vuhuyhop197/SCARA/README.md

# Classifying objects on conveyor by SCARA robot
Step_Control folder: source code Stm32F4 to control stepper motor.
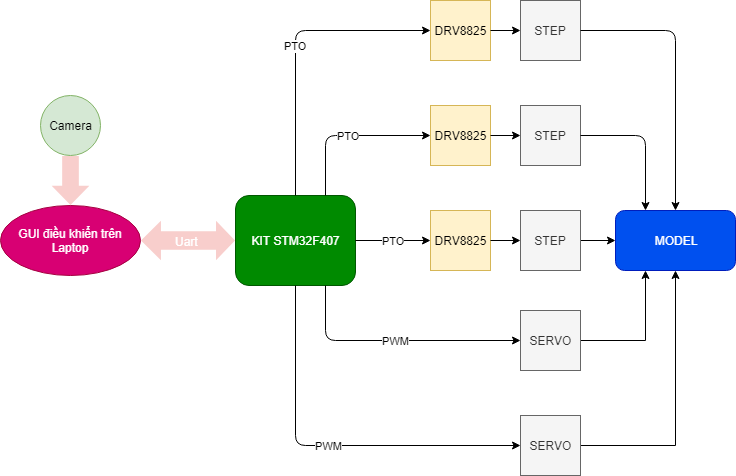
[picture p1: blockdiagram.png]
