vuhuyhop197/SCARA/Step_Control/MDK-ARM/LV_code_v2/LV_code_v2.htm

# Static Call Graph for image LV_code_v2\LV_code_v2.axf

#<CALLGRAPH># ARM Linker, 5060528: Last Updated: Sun Jun 02 16:51:38 2019

### Maximum Stack Usage = 240 bytes + Unknown(Cycles, Untraceable Function Pointers)

### Call chain for Maximum Stack Depth:

UART4_IRQHandler ⇒ HAL_UART_IRQHandler ⇒ UART_Receive_IT ⇒ HAL_UART_RxCpltCallback ⇒ Serial_RxCallback ⇒ Decode ⇒ DecodeParam ⇒ DecodeValue ⇒ ExecuteRequest ⇒ SetParamValue ⇒ Stepper_SetMinSPS ⇒ Stepper_SaveConfig ⇒ HAL_FLASH_Program ⇒ FLASH_WaitForLastOperation

### Mutually Recursive functions

- ADC_IRQHandler ⇒ ADC_IRQHandler
- BusFault_Handler ⇒ BusFault_Handler
- HardFault_Handler ⇒ HardFault_Handler
- MemManage_Handler ⇒ MemManage_Handler
- DecodeCmd ⇒ DecodeCmd
- UsageFault_Handler ⇒ UsageFault_Handler
- _Error_Handler ⇒ _Error_Handler

### Function Pointers

- ADC_IRQHandler from startup_stm32f407xx.o(.text) referenced from startup_stm32f407xx.o(RESET)
- BusFault_Handler from stm32f4xx_it.o(i.BusFault_Handler) referenced from startup_stm32f407xx.o(RESET)
- CAN1_RX0_IRQHandler from startup_stm32f407xx.o(.text) referenced from startup_stm32f407xx.o(RESET)
- CAN1_RX1_IRQHandler from startup_stm32f407xx.o(.text) referenced from startup_stm32f407xx.o(RESET)
- CAN1_SCE_IRQHandler from startup_stm32f407xx.o(.text) referenced from startup_stm32f407xx.o(RESET)
- CAN1_TX_IRQHandler from startup_stm32f407xx.o(.text) referenced from startup_stm32f407xx.o(RESET)
- CAN2_RX0_IRQHandler from startup_stm32f407xx.o(.text) referenced from startup_stm32f407xx.o(RESET)
- CAN2_RX1_IRQHandler from startup_stm32f407xx.o(.text) referenced from startup_stm32f407xx.o(RESET)
- CAN2_SCE_IRQHandler from startup_stm32f407xx.o(.text) referenced from startup_stm32f407xx.o(RESET)
- CAN2_TX_IRQHandler from startup_stm32f407xx.o(.text) referenced from startup_stm32f407xx.o(RESET)
- DCMI_IRQHandler from startup_stm32f407xx.o(.text) referenced from startup_stm32f407xx.o(RESET)
- DMA1_Stream0_IRQHandler from startup_stm32f407xx.o(.text) referenced from startup_stm32f407xx.o(RESET)
- DMA1_Stream1_IRQHandler from startup_stm32f407xx.o(.text) referenced from startup_stm32f407xx.o(RESET)
- DMA1_Stream2_IRQHandler from stm32f4xx_it.o(i.DMA1_Stream2_IRQHandler) referenced from startup_stm32f407xx.o(RESET)
- DMA1_Stream3_IRQHandler from startup_stm32f407xx.o(.text) referenced from startup_stm32f407xx.o(RESET)
- DMA1_Stream4_IRQHandler from stm32f4xx_it.o(i.DMA1_Stream4_IRQHandler) referenced from startup_stm32f407xx.o(RESET)
- DMA1_Stream5_IRQHandler from startup_stm32f407xx.o(.text) referenced from startup_stm32f407xx.o(RESET)
- DMA1_Stream6_IRQHandler from startup_stm32f407xx.o(.text) referenced from startup_stm32f407xx.o(RESET)
- DMA1_Stream7_IRQHandler from startup_stm32f407xx.o(.text) referenced from startup_stm32f407xx.o(RESET)
- DMA2_Stream0_IRQHandler from startup_stm32f407xx.o(.text) referenced from startup_stm32f407xx.o(RESET)
- DMA2_Stream1_IRQHandler from startup_stm32f407xx.o(.text) referenced from startup_stm32f407xx.o(RESET)
- DMA2_Stream2_IRQHandler from startup_stm32f407xx.o(.text) referenced from startup_stm32f407xx.o(RESET)
- DMA2_Stream3_IRQHandler from startup_stm32f407xx.o(.text) referenced from startup_stm32f407xx.o(RESET)
- DMA2_Stream4_IRQHandler from startup_stm32f407xx.o(.text) referenced from startup_stm32f407xx.o(RESET)
- DMA2_Stream5_IRQHandler from startup_stm32f407xx.o(.text) referenced from startup_stm32f407xx.o(RESET)
- DMA2_Stream6_IRQHandler from startup_stm32f407xx.o(.text) referenced from startup_stm32f407xx.o(RESET)
- DMA2_Stream7_IRQHandler from startup_stm32f407xx.o(.text) referenced from startup_stm32f407xx.o(RESET)
- DebugMon_Handler from stm32f4xx_it.o(i.DebugMon_Handler) referenced from startup_stm32f407xx.o(RESET)
- ETH_IRQHandler from startup_stm32f407xx.o(.text) referenced from startup_stm32f407xx.o(RESET)
- ETH_WKUP_IRQHandler from startup_stm32f407xx.o(.text) referenced from startup_stm32f407xx.o(RESET)
- EXTI0_IRQHandler from startup_stm32f407xx.o(.text) referenced from startup_stm32f407xx.o(RESET)
- EXTI15_10_IRQHandler from stm32f4xx_it.o(i.EXTI15_10_IRQHandler) referenced from startup_stm32f407xx.o(RESET)
- EXTI1_IRQHandler from startup_stm32f407xx.o(.text) referenced from startup_stm32f407xx.o(RESET)
- EXTI2_IRQHandler from startup_stm32f407xx.o(.text) referenced from startup_stm32f407xx.o(RESET)
- EXTI3_IRQHandler from startup_stm32f407xx.o(.text) referenced from startup_stm32f407xx.o(RESET)
- EXTI4_IRQHandler from startup_stm32f407xx.o(.text) referenced from startup_stm32f407xx.o(RESET)
- EXTI9_5_IRQHandler from startup_stm32f407xx.o(.text) referenced from startup_stm32f407xx.o(RESET)
- FLASH_IRQHandler from startup_stm32f407xx.o(.text) referenced from startup_stm32f407xx.o(RESET)
- FMC_IRQHandler from startup_stm32f407xx.o(.text) referenced from startup_stm32f407xx.o(RESET)
- FPU_IRQHandler from startup_stm32f407xx.o(.text) referenced from startup_stm32f407xx.o(RESET)
- HASH_RNG_IRQHandler from startup_stm32f407xx.o(.text) referenced from startup_stm32f407xx.o(RESET)
- HardFault_Handler from stm32f4xx_it.o(i.HardFault_Handler) referenced from startup_stm32f407xx.o(RESET)
- I2C1_ER_IRQHandler from startup_stm32f407xx.o(.text) referenced from startup_stm32f407xx.o(RESET)
- I2C1_EV_IRQHandler from startup_stm32f407xx.o(.text) referenced from startup_stm32f407xx.o(RESET)
- I2C2_ER_IRQHandler from startup_stm32f407xx.o(.text) referenced from startup_stm32f407xx.o(RESET)
- I2C2_EV_IRQHandler from startup_stm32f407xx.o(.text) referenced from startup_stm32f407xx.o(RESET)
- I2C3_ER_IRQHandler from startup_stm32f407xx.o(.text) referenced from startup_stm32f407xx.o(RESET)
- I2C3_EV_IRQHandler from startup_stm32f407xx.o(.text) referenced from startup_stm32f407xx.o(RESET)
- MemManage_Handler from stm32f4xx_it.o(i.MemManage_Handler) referenced from startup_stm32f407xx.o(RESET)
- NMI_Handler from stm32f4xx_it.o(i.NMI_Handler) referenced from startup_stm32f407xx.o(RESET)
- OTG_FS_IRQHandler from startup_stm32f407xx.o(.text) referenced from startup_stm32f407xx.o(RESET)
- OTG_FS_WKUP_IRQHandler from startup_stm32f407xx.o(.text) referenced from startup_stm32f407xx.o(RESET)
- OTG_HS_EP1_IN_IRQHandler from startup_stm32f407xx.o(.text) referenced from startup_stm32f407xx.o(RESET)
- OTG_HS_EP1_OUT_IRQHandler from startup_stm32f407xx.o(.text) referenced from startup_stm32f407xx.o(RESET)
- OTG_HS_IRQHandler from startup_stm32f407xx.o(.text) referenced from startup_stm32f407xx.o(RESET)
- OTG_HS_WKUP_IRQHandler from startup_stm32f407xx.o(.text) referenced from startup_stm32f407xx.o(RESET)
- PVD_IRQHandler from startup_stm32f407xx.o(.text) referenced from startup_stm32f407xx.o(RESET)
- PendSV_Handler from stm32f4xx_it.o(i.PendSV_Handler) referenced from startup_stm32f407xx.o(RESET)
- RCC_IRQHandler from startup_stm32f407xx.o(.text) referenced from startup_stm32f407xx.o(RESET)
- RTC_Alarm_IRQHandler from startup_stm32f407xx.o(.text) referenced from startup_stm32f407xx.o(RESET)
- RTC_WKUP_IRQHandler from startup_stm32f407xx.o(.text) referenced from startup_stm32f407xx.o(RESET)
- Reset_Handler from startup_stm32f407xx.o(.text) referenced from startup_stm32f407xx.o(RESET)
- SDIO_IRQHandler from startup_stm32f407xx.o(.text) referenced from startup_stm32f407xx.o(RESET)
- SPI1_IRQHandler from startup_stm32f407xx.o(.text) referenced from startup_stm32f407xx.o(RESET)
- SPI2_IRQHandler from startup_stm32f407xx.o(.text) referenced from startup_stm32f407xx.o(RESET)
- SPI3_IRQHandler from startup_stm32f407xx.o(.text) referenced from startup_stm32f407xx.o(RESET)
- SVC_Handler from stm32f4xx_it.o(i.SVC_Handler) referenced from startup_stm32f407xx.o(RESET)
- SysTick_Handler from stm32f4xx_it.o(i.SysTick_Handler) referenced from startup_stm32f407xx.o(RESET)
- SystemInit from system_stm32f4xx_1.o(i.SystemInit) referenced from startup_stm32f407xx.o(.text)
- TAMP_STAMP_IRQHandler from startup_stm32f407xx.o(.text) referenced from startup_stm32f407xx.o(RESET)
- TIM1_BRK_TIM9_IRQHandler from startup_stm32f407xx.o(.text) referenced from startup_stm32f407xx.o(RESET)
- TIM1_CC_IRQHandler from startup_stm32f407xx.o(.text) referenced from startup_stm32f407xx.o(RESET)
- TIM1_TRG_COM_TIM11_IRQHandler from startup_stm32f407xx.o(.text) referenced from startup_stm32f407xx.o(RESET)
- TIM1_UP_TIM10_IRQHandler from startup_stm32f407xx.o(.text) referenced from startup_stm32f407xx.o(RESET)
- TIM2_IRQHandler from startup_stm32f407xx.o(.text) referenced from startup_stm32f407xx.o(RESET)
- TIM3_IRQHandler from stm32f4xx_it.o(i.TIM3_IRQHandler) referenced from startup_stm32f407xx.o(RESET)
- TIM4_IRQHandler from stm32f4xx_it.o(i.TIM4_IRQHandler) referenced from startup_stm32f407xx.o(RESET)
- TIM5_IRQHandler from stm32f4xx_it.o(i.TIM5_IRQHandler) referenced from startup_stm32f407xx.o(RESET)
- TIM6_DAC_IRQHandler from startup_stm32f407xx.o(.text) referenced from startup_stm32f407xx.o(RESET)
- TIM7_IRQHandler from startup_stm32f407xx.o(.text) referenced from startup_stm32f407xx.o(RESET)
- TIM8_BRK_TIM12_IRQHandler from startup_stm32f407xx.o(.text) referenced from startup_stm32f407xx.o(RESET)
- TIM8_CC_IRQHandler from startup_stm32f407xx.o(.text) referenced from startup_stm32f407xx.o(RESET)
- TIM8_TRG_COM_TIM14_IRQHandler from stm32f4xx_it.o(i.TIM8_TRG_COM_TIM14_IRQHandler) referenced from startup_stm32f407xx.o(RESET)
- TIM8_UP_TIM13_IRQHandler from startup_stm32f407xx.o(.text) referenced from startup_stm32f407xx.o(RESET)
- UART4_IRQHandler from stm32f4xx_it.o(i.UART4_IRQHandler) referenced from startup_stm32f407xx.o(RESET)
- UART5_IRQHandler from startup_stm32f407xx.o(.text) referenced from startup_stm32f407xx.o(RESET)
- UART_DMAAbortOnError from stm32f4xx_hal_uart.o(i.UART_DMAAbortOnError) referenced from stm32f4xx_hal_uart.o(i.HAL_UART_IRQHandler)
- UART_DMAError from stm32f4xx_hal_uart.o(i.UART_DMAError) referenced from stm32f4xx_hal_uart.o(i.HAL_UART_Receive_DMA)
- UART_DMAError from stm32f4xx_hal_uart.o(i.UART_DMAError) referenced from stm32f4xx_hal_uart.o(i.HAL_UART_Transmit_DMA)
- UART_DMAReceiveCplt from stm32f4xx_hal_uart.o(i.UART_DMAReceiveCplt) referenced from stm32f4xx_hal_uart.o(i.HAL_UART_Receive_DMA)
- UART_DMARxHalfCplt from stm32f4xx_hal_uart.o(i.UART_DMARxHalfCplt) referenced from stm32f4xx_hal_uart.o(i.HAL_UART_Receive_DMA)
- UART_DMATransmitCplt from stm32f4xx_hal_uart.o(i.UART_DMATransmitCplt) referenced from stm32f4xx_hal_uart.o(i.HAL_UART_Transmit_DMA)
- UART_DMATxHalfCplt from stm32f4xx_hal_uart.o(i.UART_DMATxHalfCplt) referenced from stm32f4xx_hal_uart.o(i.HAL_UART_Transmit_DMA)
- USART1_IRQHandler from startup_stm32f407xx.o(.text) referenced from startup_stm32f407xx.o(RESET)
- USART2_IRQHandler from startup_stm32f407xx.o(.text) referenced from startup_stm32f407xx.o(RESET)
- USART3_IRQHandler from startup_stm32f407xx.o(.text) referenced from startup_stm32f407xx.o(RESET)
- USART6_IRQHandler from startup_stm32f407xx.o(.text) referenced from startup_stm32f407xx.o(RESET)
- UsageFault_Handler from stm32f4xx_it.o(i.UsageFault_Handler) referenced from startup_stm32f407xx.o(RESET)
- WWDG_IRQHandler from startup_stm32f407xx.o(.text) referenced from startup_stm32f407xx.o(RESET)
- __main from entry.o(.ARM.Collect$$$$00000000) referenced from startup_stm32f407xx.o(.text)
- fputc from serial.o(i.fputc) referenced from printf5.o(i.__0printf$5)
- main from main.o(i.main) referenced from entry9a.o(.ARM.Collect$$$$0000000B)

### Global Symbols

__main (Thumb, 0 bytes, Stack size unknown bytes, entry.o(.ARM.Collect$$$$00000000))
[Address Reference Count : 1]

- startup_stm32f407xx.o(.text)

_main_stk (Thumb, 0 bytes, Stack size unknown bytes, entry2.o(.ARM.Collect$$$$00000001))

_main_scatterload (Thumb, 0 bytes, Stack size unknown bytes, entry5.o(.ARM.Collect$$$$00000004))

[Calls]

- >> __scatterload

__main_after_scatterload (Thumb, 0 bytes, Stack size unknown bytes, entry5.o(.ARM.Collect$$$$00000004))

[Called By]

- >> __scatterload

_main_clock (Thumb, 0 bytes, Stack size unknown bytes, entry7b.o(.ARM.Collect$$$$00000008))

_main_cpp_init (Thumb, 0 bytes, Stack size unknown bytes, entry8b.o(.ARM.Collect$$$$0000000A))

_main_init (Thumb, 0 bytes, Stack size unknown bytes, entry9a.o(.ARM.Collect$$$$0000000B))

__rt_final_cpp (Thumb, 0 bytes, Stack size unknown bytes, entry10a.o(.ARM.Collect$$$$0000000D))

__rt_final_exit (Thumb, 0 bytes, Stack size unknown bytes, entry11a.o(.ARM.Collect$$$$0000000F))

Reset_Handler (Thumb, 8 bytes, Stack size 0 bytes, startup_stm32f407xx.o(.text))
[Address Reference Count : 1]

- startup_stm32f407xx.o(RESET)

ADC_IRQHandler (Thumb, 0 bytes, Stack size 0 bytes, startup_stm32f407xx.o(.text))

[Calls]

- >> ADC_IRQHandler

[Called By]

- >> ADC_IRQHandler

[Address Reference Count : 1]

- startup_stm32f407xx.o(RESET)

CAN1_RX0_IRQHandler (Thumb, 0 bytes, Stack size 0 bytes, startup_stm32f407xx.o(.text))
[Address Reference Count : 1]

- startup_stm32f407xx.o(RESET)

CAN1_RX1_IRQHandler (Thumb, 0 bytes, Stack size 0 bytes, startup_stm32f407xx.o(.text))
[Address Reference Count : 1]

- startup_stm32f407xx.o(RESET)

CAN1_SCE_IRQHandler (Thumb, 0 bytes, Stack size 0 bytes, startup_stm32f407xx.o(.text))
[Address Reference Count : 1]

- startup_stm32f407xx.o(RESET)

CAN1_TX_IRQHandler (Thumb, 0 bytes, Stack size 0 bytes, startup_stm32f407xx.o(.text))
[Address Reference Count : 1]

- startup_stm32f407xx.o(RESET)

CAN2_RX0_IRQHandler (Thumb, 0 bytes, Stack size 0 bytes, startup_stm32f407xx.o(.text))
[Address Reference Count : 1]

- startup_stm32f407xx.o(RESET)

CAN2_RX1_IRQHandler (Thumb, 0 bytes, Stack size 0 bytes, startup_stm32f407xx.o(.text))
[Address Reference Count : 1]

- startup_stm32f407xx.o(RESET)

CAN2_SCE_IRQHandler (Thumb, 0 bytes, Stack size 0 bytes, startup_stm32f407xx.o(.text))
[Address Reference Count : 1]

- startup_stm32f407xx.o(RESET)

CAN2_TX_IRQHandler (Thumb, 0 bytes, Stack size 0 bytes, startup_stm32f407xx.o(.text))
[Address Reference Count : 1]

- startup_stm32f407xx.o(RESET)

DCMI_IRQHandler (Thumb, 0 bytes, Stack size 0 bytes, startup_stm32f407xx.o(.text))
[Address Reference Count : 1]

- startup_stm32f407xx.o(RESET)

DMA1_Stream0_IRQHandler (Thumb, 0 bytes, Stack size 0 bytes, startup_stm32f407xx.o(.text))
[Address Reference Count : 1]

- startup_stm32f407xx.o(RESET)

DMA1_Stream1_IRQHandler (Thumb, 0 bytes, Stack size 0 bytes, startup_stm32f407xx.o(.text))
[Address Reference Count : 1]

- startup_stm32f407xx.o(RESET)

DMA1_Stream3_IRQHandler (Thumb, 0 bytes, Stack size 0 bytes, startup_stm32f407xx.o(.text))
[Address Reference Count : 1]

- startup_stm32f407xx.o(RESET)

DMA1_Stream5_IRQHandler (Thumb, 0 bytes, Stack size 0 bytes, startup_stm32f407xx.o(.text))
[Address Reference Count : 1]

- startup_stm32f407xx.o(RESET)

DMA1_Stream6_IRQHandler (Thumb, 0 bytes, Stack size 0 bytes, startup_stm32f407xx.o(.text))
[Address Reference Count : 1]

- startup_stm32f407xx.o(RESET)

DMA1_Stream7_IRQHandler (Thumb, 0 bytes, Stack size 0 bytes, startup_stm32f407xx.o(.text))
[Address Reference Count : 1]

- startup_stm32f407xx.o(RESET)

DMA2_Stream0_IRQHandler (Thumb, 0 bytes, Stack size 0 bytes, startup_stm32f407xx.o(.text))
[Address Reference Count : 1]

- startup_stm32f407xx.o(RESET)

DMA2_Stream1_IRQHandler (Thumb, 0 bytes, Stack size 0 bytes, startup_stm32f407xx.o(.text))
[Address Reference Count : 1]

- startup_stm32f407xx.o(RESET)

DMA2_Stream2_IRQHandler (Thumb, 0 bytes, Stack size 0 bytes, startup_stm32f407xx.o(.text))
[Address Reference Count : 1]

- startup_stm32f407xx.o(RESET)

DMA2_Stream3_IRQHandler (Thumb, 0 bytes, Stack size 0 bytes, startup_stm32f407xx.o(.text))
[Address Reference Count : 1]

- startup_stm32f407xx.o(RESET)

DMA2_Stream4_IRQHandler (Thumb, 0 bytes, Stack size 0 bytes, startup_stm32f407xx.o(.text))
[Address Reference Count : 1]

- startup_stm32f407xx.o(RESET)

DMA2_Stream5_IRQHandler (Thumb, 0 bytes, Stack size 0 bytes, startup_stm32f407xx.o(.text))
[Address Reference Count : 1]

- startup_stm32f407xx.o(RESET)

DMA2_Stream6_IRQHandler (Thumb, 0 bytes, Stack size 0 bytes, startup_stm32f407xx.o(.text))
[Address Reference Count : 1]

- startup_stm32f407xx.o(RESET)

DMA2_Stream7_IRQHandler (Thumb, 0 bytes, Stack size 0 bytes, startup_stm32f407xx.o(.text))
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

- startup_stm32f407xx.o(RESET)

SDIO_IRQHandler (Thumb, 0 bytes, Stack size 0 bytes, startup_stm32f407xx.o(.text))
[Address Reference Count : 1]

- startup_stm32f407xx.o(RESET)

SPI1_IRQHandler (Thumb, 0 bytes, Stack size 0 bytes, startup_stm32f407xx.o(.text))
[Address Reference Count : 1]

- startup_stm32f407xx.o(RESET)

SPI2_IRQHandler (Thumb, 0 bytes, Stack size 0 bytes, startup_stm32f407xx.o(.text))
[Address Reference Count : 1]

- startup_stm32f407xx.o(RESET)

SPI3_IRQHandler (Thumb, 0 bytes, Stack size 0 bytes, startup_stm32f407xx.o(.text))
[Address Reference Count : 1]

- startup_stm32f407xx.o(RESET)

TAMP_STAMP_IRQHandler (Thumb, 0 bytes, Stack size 0 bytes, startup_stm32f407xx.o(.text))
[Address Reference Count : 1]

- startup_stm32f407xx.o(RESET)

TIM1_BRK_TIM9_IRQHandler (Thumb, 0 bytes, Stack size 0 bytes, startup_stm32f407xx.o(.text))
[Address Reference Count : 1]

- startup_stm32f407xx.o(RESET)

TIM1_CC_IRQHandler (Thumb, 0 bytes, Stack size 0 bytes, startup_stm32f407xx.o(.text))
[Address Reference Count : 1]

- startup_stm32f407xx.o(RESET)

TIM1_TRG_COM_TIM11_IRQHandler (Thumb, 0 bytes, Stack size 0 bytes, startup_stm32f407xx.o(.text))
[Address Reference Count : 1]

- startup_stm32f407xx.o(RESET)

TIM1_UP_TIM10_IRQHandler (Thumb, 0 bytes, Stack size 0 bytes, startup_stm32f407xx.o(.text))
[Address Reference Count : 1]

- startup_stm32f407xx.o(RESET)

TIM2_IRQHandler (Thumb, 0 bytes, Stack size 0 bytes, startup_stm32f407xx.o(.text))
[Address Reference Count : 1]

- startup_stm32f407xx.o(RESET)

TIM6_DAC_IRQHandler (Thumb, 0 bytes, Stack size 0 bytes, startup_stm32f407xx.o(.text))
[Address Reference Count : 1]

- startup_stm32f407xx.o(RESET)

TIM7_IRQHandler (Thumb, 0 bytes, Stack size 0 bytes, startup_stm32f407xx.o(.text))
[Address Reference Count : 1]

- startup_stm32f407xx.o(RESET)

TIM8_BRK_TIM12_IRQHandler (Thumb, 0 bytes, Stack size 0 bytes, startup_stm32f407xx.o(.text))
[Address Reference Count : 1]

- startup_stm32f407xx.o(RESET)

TIM8_CC_IRQHandler (Thumb, 0 bytes, Stack size 0 bytes, startup_stm32f407xx.o(.text))
[Address Reference Count : 1]

- startup_stm32f407xx.o(RESET)

TIM8_UP_TIM13_IRQHandler (Thumb, 0 bytes, Stack size 0 bytes, startup_stm32f407xx.o(.text))
[Address Reference Count : 1]

- startup_stm32f407xx.o(RESET)

UART5_IRQHandler (Thumb, 0 bytes, Stack size 0 bytes, startup_stm32f407xx.o(.text))
[Address Reference Count : 1]

- startup_stm32f407xx.o(RESET)

USART1_IRQHandler (Thumb, 0 bytes, Stack size 0 bytes, startup_stm32f407xx.o(.text))
[Address Reference Count : 1]

- startup_stm32f407xx.o(RESET)

USART2_IRQHandler (Thumb, 0 bytes, Stack size 0 bytes, startup_stm32f407xx.o(.text))
[Address Reference Count : 1]

- startup_stm32f407xx.o(RESET)

USART3_IRQHandler (Thumb, 0 bytes, Stack size 0 bytes, startup_stm32f407xx.o(.text))
[Address Reference Count : 1]

- startup_stm32f407xx.o(RESET)

USART6_IRQHandler (Thumb, 0 bytes, Stack size 0 bytes, startup_stm32f407xx.o(.text))
[Address Reference Count : 1]

- startup_stm32f407xx.o(RESET)

WWDG_IRQHandler (Thumb, 0 bytes, Stack size 0 bytes, startup_stm32f407xx.o(.text))
[Address Reference Count : 1]

- startup_stm32f407xx.o(RESET)

__aeabi_uldivmod (Thumb, 98 bytes, Stack size 40 bytes, uldiv.o(.text))

[Stack]

- Max Depth = 40
- Call Chain = __aeabi_uldivmod

[Calls]

- >> __aeabi_llsr
- >> __aeabi_llsl

[Called By]

- >> HAL_RCC_GetSysClockFreq
- >> _printf_core

__aeabi_memcpy (Thumb, 36 bytes, Stack size 0 bytes, memcpya.o(.text), UNUSED)

__aeabi_memcpy4 (Thumb, 0 bytes, Stack size 0 bytes, memcpya.o(.text))

[Called By]

- >> main

__aeabi_memcpy8 (Thumb, 0 bytes, Stack size 0 bytes, memcpya.o(.text), UNUSED)

strlen (Thumb, 14 bytes, Stack size 0 bytes, strlen.o(.text))

[Called By]

- >> DecodeParam
- >> DecodeCmd
- >> HAL_UART_TxCpltCallback

__aeabi_l2f (Thumb, 44 bytes, Stack size 16 bytes, ffltl.o(.text))

[Stack]

- Max Depth = 20
- Call Chain = __aeabi_l2f ⇒ _float_epilogue

[Calls]

- >> _float_epilogue

[Called By]

- >> ExecuteRequest
- >> ExecuteController

__aeabi_llsl (Thumb, 30 bytes, Stack size 0 bytes, llshl.o(.text))

[Called By]

- >> __aeabi_uldivmod

_ll_shift_l (Thumb, 0 bytes, Stack size 0 bytes, llshl.o(.text), UNUSED)

__aeabi_llsr (Thumb, 32 bytes, Stack size 0 bytes, llushr.o(.text))

[Called By]

- >> __aeabi_uldivmod

_ll_ushift_r (Thumb, 0 bytes, Stack size 0 bytes, llushr.o(.text), UNUSED)

__I$use$fp (Thumb, 0 bytes, Stack size 0 bytes, iusefp.o(.text), UNUSED)

_float_round (Thumb, 18 bytes, Stack size 0 bytes, fepilogue.o(.text), UNUSED)

_float_epilogue (Thumb, 92 bytes, Stack size 4 bytes, fepilogue.o(.text))

[Stack]

- Max Depth = 4
- Call Chain = _float_epilogue

[Called By]

- >> __aeabi_l2f

__scatterload (Thumb, 28 bytes, Stack size 0 bytes, init.o(.text))

[Calls]

- >> __main_after_scatterload

[Called By]

- >> _main_scatterload

__scatterload_rt2 (Thumb, 0 bytes, Stack size 0 bytes, init.o(.text), UNUSED)

BusFault_Handler (Thumb, 2 bytes, Stack size 0 bytes, stm32f4xx_it.o(i.BusFault_Handler))

[Calls]

- >> BusFault_Handler

[Called By]

- >> BusFault_Handler

[Address Reference Count : 1]

- startup_stm32f407xx.o(RESET)

Calib_Home (Thumb, 140 bytes, Stack size 8 bytes, main.o(i.Calib_Home))

[Stack]

- Max Depth = 16
- Call Chain = Calib_Home ⇒ Stepper_SetTargetPosition

[Calls]

- >> HAL_GPIO_WritePin
- >> Stepper_SetTargetPosition
- >> Stepper_SetCurrentPosition
- >> Stepper_GetStatus
- >> Stepper_GetCurrentPosition

[Called By]

- >> main

CleanupDecoder (Thumb, 26 bytes, Stack size 0 bytes, steppercommands.o(i.CleanupDecoder))

[Called By]

- >> DecodeValue
- >> DecodeStepper

DMA1_Stream2_IRQHandler (Thumb, 6 bytes, Stack size 0 bytes, stm32f4xx_it.o(i.DMA1_Stream2_IRQHandler))

[Stack]

- Max Depth = 32
- Call Chain = DMA1_Stream2_IRQHandler ⇒ HAL_DMA_IRQHandler

[Calls]

- >> HAL_DMA_IRQHandler

[Address Reference Count : 1]

- startup_stm32f407xx.o(RESET)

DMA1_Stream4_IRQHandler (Thumb, 6 bytes, Stack size 0 bytes, stm32f4xx_it.o(i.DMA1_Stream4_IRQHandler))

[Stack]

- Max Depth = 32
- Call Chain = DMA1_Stream4_IRQHandler ⇒ HAL_DMA_IRQHandler

[Calls]

- >> HAL_DMA_IRQHandler

[Address Reference Count : 1]

- startup_stm32f407xx.o(RESET)

DebugMon_Handler (Thumb, 2 bytes, Stack size 0 bytes, stm32f4xx_it.o(i.DebugMon_Handler))
[Address Reference Count : 1]

- startup_stm32f407xx.o(RESET)

Decode (Thumb, 48 bytes, Stack size 0 bytes, steppercommands.o(i.Decode))

[Stack]

- Max Depth = 200
- Call Chain = Decode ⇒ DecodeParam ⇒ DecodeValue ⇒ ExecuteRequest ⇒ SetParamValue ⇒ Stepper_SetMinSPS ⇒ Stepper_SaveConfig ⇒ HAL_FLASH_Program ⇒ FLASH_WaitForLastOperation

[Calls]

- >> DecodeValue
- >> DecodeStepper
- >> DecodeParam
- >> DecodeCmd

[Called By]

- >> Serial_RxCallback

DecodeCmd (Thumb, 180 bytes, Stack size 40 bytes, steppercommands.o(i.DecodeCmd))

[Stack]

- Max Depth = 40 + In Cycle
- Call Chain = DecodeCmd ⇒ DecodeCmd (Cycle)

[Calls]

- >> DecodeCmd
- >> strlen

[Called By]

- >> DecodeValue
- >> DecodeStepper
- >> DecodeCmd
- >> Decode

DecodeParam (Thumb, 210 bytes, Stack size 40 bytes, steppercommands.o(i.DecodeParam))

[Stack]

- Max Depth = 200
- Call Chain = DecodeParam ⇒ DecodeValue ⇒ ExecuteRequest ⇒ SetParamValue ⇒ Stepper_SetMinSPS ⇒ Stepper_SaveConfig ⇒ HAL_FLASH_Program ⇒ FLASH_WaitForLastOperation

[Calls]

- >> DecodeValue
- >> strlen

[Called By]

- >> Decode

DecodeStepper (Thumb, 48 bytes, Stack size 8 bytes, steppercommands.o(i.DecodeStepper))

[Stack]

- Max Depth = 144
- Call Chain = DecodeStepper ⇒ ExecuteRequest ⇒ SetParamValue ⇒ Stepper_SetMinSPS ⇒ Stepper_SaveConfig ⇒ HAL_FLASH_Program ⇒ FLASH_WaitForLastOperation

[Calls]

- >> ExecuteRequest
- >> DecodeCmd
- >> CleanupDecoder
- >> Stepper_GetStatus

[Called By]

- >> Decode

DecodeValue (Thumb, 170 bytes, Stack size 24 bytes, steppercommands.o(i.DecodeValue))

[Stack]

- Max Depth = 160
- Call Chain = DecodeValue ⇒ ExecuteRequest ⇒ SetParamValue ⇒ Stepper_SetMinSPS ⇒ Stepper_SaveConfig ⇒ HAL_FLASH_Program ⇒ FLASH_WaitForLastOperation

[Calls]

- >> ExecuteRequest
- >> DecodeCmd
- >> CleanupDecoder

[Called By]

- >> DecodeParam
- >> Decode

DecrementSPS (Thumb, 22 bytes, Stack size 0 bytes, steppercontroller.o(i.DecrementSPS))

[Stack]

- Max Depth = 8
- Call Chain = DecrementSPS ⇒ SetStepTimerByCurrentSPS

[Calls]

- >> SetStepTimerByCurrentSPS

[Called By]

- >> ExecuteController

EXTI15_10_IRQHandler (Thumb, 22 bytes, Stack size 8 bytes, stm32f4xx_it.o(i.EXTI15_10_IRQHandler))

[Stack]

- Max Depth = 32
- Call Chain = EXTI15_10_IRQHandler ⇒ HAL_GPIO_EXTI_IRQHandler ⇒ HAL_GPIO_EXTI_Callback

[Calls]

- >> HAL_GPIO_EXTI_IRQHandler

[Address Reference Count : 1]

- startup_stm32f407xx.o(RESET)

ExecuteController (Thumb, 316 bytes, Stack size 24 bytes, steppercontroller.o(i.ExecuteController))

[Stack]

- Max Depth = 44
- Call Chain = ExecuteController ⇒ __aeabi_l2f ⇒ _float_epilogue

[Calls]

- >> HAL_TIM_PWM_Start
- >> __aeabi_l2f
- >> IncrementSPS
- >> GetStepsToTarget
- >> DecrementSPS

[Called By]

- >> Stepper_ExecuteAllControllers

ExecuteRequest (Thumb, 588 bytes, Stack size 32 bytes, steppercommands.o(i.ExecuteRequest))

[Stack]

- Max Depth = 136
- Call Chain = ExecuteRequest ⇒ SetParamValue ⇒ Stepper_SetMinSPS ⇒ Stepper_SaveConfig ⇒ HAL_FLASH_Program ⇒ FLASH_WaitForLastOperation

[Calls]

- >> Set_Orient
- >> Set_Home
- >> Grap_object
- >> SetParamValue
- >> PrintStepperStatusStr
- >> GetParamValue
- >> __aeabi_l2f
- >> Stepper_SetMinSPS
- >> Stepper_SetMaxSPS
- >> Stepper_SetCurrentPosition
- >> Stepper_SaveConfig
- >> Stepper_InitDefaultState
- >> Stepper_GetStatus
- >> __2printf

[Called By]

- >> main
- >> DecodeValue
- >> DecodeStepper

FLASH_Erase_Sector (Thumb, 76 bytes, Stack size 0 bytes, stm32f4xx_hal_flash_ex.o(i.FLASH_Erase_Sector))

[Called By]

- >> Stepper_SaveConfig

FLASH_WaitForLastOperation (Thumb, 76 bytes, Stack size 16 bytes, stm32f4xx_hal_flash.o(i.FLASH_WaitForLastOperation))

[Stack]

- Max Depth = 16
- Call Chain = FLASH_WaitForLastOperation

[Calls]

- >> FLASH_SetErrorCode
- >> HAL_GetTick

[Called By]

- >> HAL_FLASH_Program

GetParamValue (Thumb, 54 bytes, Stack size 0 bytes, steppercommands.o(i.GetParamValue))

[Stack]

- Max Depth = 4
- Call Chain = GetParamValue ⇒ Stepper_GetTargetPosition

[Calls]

- >> Stepper_GetTargetPosition
- >> Stepper_GetStatus
- >> Stepper_GetMinSPS
- >> Stepper_GetMaxSPS
- >> Stepper_GetCurrentSPS
- >> Stepper_GetCurrentPosition
- >> Stepper_GetAccSPS
- >> Stepper_GetAccPrescaler

[Called By]

- >> ExecuteRequest

GetState (Thumb, 40 bytes, Stack size 0 bytes, steppercontroller.o(i.GetState))

[Called By]

- >> Stepper_SetupPeripherals
- >> Stepper_SetTargetPosition
- >> Stepper_SetMinSPS
- >> Stepper_SetMaxSPS
- >> Stepper_SetCurrentPosition
- >> Stepper_SetAccSPS
- >> Stepper_SetAccPrescaler
- >> Stepper_PulseTimerUpdate
- >> Stepper_InitDefaultState
- >> Stepper_GetTargetPosition
- >> Stepper_GetStatus
- >> Stepper_GetMinSPS
- >> Stepper_GetMaxSPS
- >> Stepper_GetCurrentSPS
- >> Stepper_GetCurrentPosition
- >> Stepper_GetAccSPS
- >> Stepper_GetAccPrescaler

GetStepDirectionUnit (Thumb, 18 bytes, Stack size 0 bytes, steppercontroller.o(i.GetStepDirectionUnit))

[Called By]

- >> Stepper_PulseTimerUpdate
- >> GetStepsToTarget

GetStepsToTarget (Thumb, 40 bytes, Stack size 12 bytes, steppercontroller.o(i.GetStepsToTarget))

[Stack]

- Max Depth = 12
- Call Chain = GetStepsToTarget

[Calls]

- >> GetStepDirectionUnit

[Called By]

- >> Stepper_PulseTimerUpdate
- >> ExecuteController

Grap_object (Thumb, 44 bytes, Stack size 8 bytes, main.o(i.Grap_object))

[Stack]

- Max Depth = 24
- Call Chain = Grap_object ⇒ HAL_TIM_PWM_Start ⇒ TIM_CCxChannelCmd

[Calls]

- >> HAL_TIM_PWM_Start

[Called By]

- >> ExecuteRequest

HAL_DMA_Abort_IT (Thumb, 36 bytes, Stack size 0 bytes, stm32f4xx_hal_dma.o(i.HAL_DMA_Abort_IT))

[Called By]

- >> HAL_UART_IRQHandler

HAL_DMA_IRQHandler (Thumb, 460 bytes, Stack size 32 bytes, stm32f4xx_hal_dma.o(i.HAL_DMA_IRQHandler))

[Stack]

- Max Depth = 32
- Call Chain = HAL_DMA_IRQHandler

[Called By]

- >> DMA1_Stream4_IRQHandler
- >> DMA1_Stream2_IRQHandler

HAL_DMA_Init (Thumb, 208 bytes, Stack size 24 bytes, stm32f4xx_hal_dma.o(i.HAL_DMA_Init))

[Stack]

- Max Depth = 32
- Call Chain = HAL_DMA_Init ⇒ DMA_CheckFifoParam

[Calls]

- >> DMA_CheckFifoParam
- >> DMA_CalcBaseAndBitshift
- >> HAL_GetTick

[Called By]

- >> HAL_UART_MspInit

HAL_DMA_Start_IT (Thumb, 120 bytes, Stack size 24 bytes, stm32f4xx_hal_dma.o(i.HAL_DMA_Start_IT))

[Stack]

- Max Depth = 36
- Call Chain = HAL_DMA_Start_IT ⇒ DMA_SetConfig

[Calls]

- >> DMA_SetConfig

[Called By]

- >> HAL_UART_Transmit_DMA
- >> HAL_UART_Receive_DMA

HAL_Delay (Thumb, 32 bytes, Stack size 16 bytes, stm32f4xx_hal.o(i.HAL_Delay))

[Stack]

- Max Depth = 16
- Call Chain = HAL_Delay

[Calls]

- >> HAL_GetTick

[Called By]

- >> main

HAL_FLASH_Lock (Thumb, 14 bytes, Stack size 0 bytes, stm32f4xx_hal_flash.o(i.HAL_FLASH_Lock))

[Called By]

- >> Stepper_SaveConfig

HAL_FLASH_Program (Thumb, 116 bytes, Stack size 32 bytes, stm32f4xx_hal_flash.o(i.HAL_FLASH_Program))

[Stack]

- Max Depth = 48
- Call Chain = HAL_FLASH_Program ⇒ FLASH_WaitForLastOperation

[Calls]

- >> FLASH_WaitForLastOperation
- >> FLASH_Program_Word
- >> FLASH_Program_HalfWord
- >> FLASH_Program_DoubleWord
- >> FLASH_Program_Byte

[Called By]

- >> Stepper_SaveConfig

HAL_FLASH_Unlock (Thumb, 32 bytes, Stack size 0 bytes, stm32f4xx_hal_flash.o(i.HAL_FLASH_Unlock))

[Called By]

- >> Stepper_SaveConfig

HAL_GPIO_EXTI_Callback (Thumb, 68 bytes, Stack size 16 bytes, main.o(i.HAL_GPIO_EXTI_Callback))

[Stack]

- Max Depth = 16
- Call Chain = HAL_GPIO_EXTI_Callback

[Calls]

- >> HAL_GPIO_WritePin

[Called By]

- >> HAL_GPIO_EXTI_IRQHandler

HAL_GPIO_EXTI_IRQHandler (Thumb, 18 bytes, Stack size 8 bytes, stm32f4xx_hal_gpio.o(i.HAL_GPIO_EXTI_IRQHandler))

[Stack]

- Max Depth = 24
- Call Chain = HAL_GPIO_EXTI_IRQHandler ⇒ HAL_GPIO_EXTI_Callback

[Calls]

- >> HAL_GPIO_EXTI_Callback

[Called By]

- >> EXTI15_10_IRQHandler

HAL_GPIO_Init (Thumb, 406 bytes, Stack size 40 bytes, stm32f4xx_hal_gpio.o(i.HAL_GPIO_Init))

[Stack]

- Max Depth = 40
- Call Chain = HAL_GPIO_Init

[Called By]

- >> HAL_TIM_MspPostInit
- >> MX_GPIO_Init
- >> HAL_UART_MspInit

HAL_GPIO_ReadPin (Thumb, 14 bytes, Stack size 0 bytes, stm32f4xx_hal_gpio.o(i.HAL_GPIO_ReadPin))

[Called By]

- >> Set_Home

HAL_GPIO_WritePin (Thumb, 14 bytes, Stack size 0 bytes, stm32f4xx_hal_gpio.o(i.HAL_GPIO_WritePin))

[Called By]

- >> main
- >> HAL_GPIO_EXTI_Callback
- >> Calib_Home
- >> MX_GPIO_Init
- >> Set_Home
- >> SetParamValue

HAL_GetTick (Thumb, 6 bytes, Stack size 0 bytes, stm32f4xx_hal.o(i.HAL_GetTick))

[Called By]

- >> HAL_DMA_Init
- >> FLASH_WaitForLastOperation
- >> HAL_RCC_OscConfig
- >> HAL_RCC_ClockConfig
- >> HAL_Delay

HAL_IncTick (Thumb, 12 bytes, Stack size 0 bytes, stm32f4xx_hal.o(i.HAL_IncTick))

[Called By]

- >> SysTick_Handler

HAL_Init (Thumb, 48 bytes, Stack size 8 bytes, stm32f4xx_hal.o(i.HAL_Init))

[Stack]

- Max Depth = 40
- Call Chain = HAL_Init ⇒ HAL_InitTick ⇒ HAL_NVIC_SetPriority

[Calls]

- >> HAL_NVIC_SetPriorityGrouping
- >> HAL_InitTick
- >> HAL_MspInit

[Called By]

- >> main

HAL_InitTick (Thumb, 58 bytes, Stack size 16 bytes, stm32f4xx_hal.o(i.HAL_InitTick))

[Stack]

- Max Depth = 32
- Call Chain = HAL_InitTick ⇒ HAL_NVIC_SetPriority

[Calls]

- >> HAL_SYSTICK_Config
- >> HAL_NVIC_SetPriority

[Called By]

- >> HAL_RCC_ClockConfig
- >> HAL_Init

HAL_MspInit (Thumb, 88 bytes, Stack size 8 bytes, stm32f4xx_hal_msp.o(i.HAL_MspInit))

[Stack]

- Max Depth = 24
- Call Chain = HAL_MspInit ⇒ HAL_NVIC_SetPriority

[Calls]

- >> HAL_NVIC_SetPriorityGrouping
- >> HAL_NVIC_SetPriority

[Called By]

- >> HAL_Init

HAL_NVIC_EnableIRQ (Thumb, 22 bytes, Stack size 0 bytes, stm32f4xx_hal_cortex.o(i.HAL_NVIC_EnableIRQ))

[Called By]

- >> MX_GPIO_Init
- >> MX_DMA_Init
- >> HAL_UART_MspInit
- >> HAL_TIM_Base_MspInit

HAL_NVIC_SetPriority (Thumb, 60 bytes, Stack size 16 bytes, stm32f4xx_hal_cortex.o(i.HAL_NVIC_SetPriority))

[Stack]

- Max Depth = 16
- Call Chain = HAL_NVIC_SetPriority

[Calls]

- >> NVIC_SetPriority

[Called By]

- >> HAL_InitTick
- >> SystemClock_Config
- >> MX_GPIO_Init
- >> MX_DMA_Init
- >> HAL_UART_MspInit
- >> HAL_TIM_Base_MspInit
- >> HAL_MspInit

HAL_NVIC_SetPriorityGrouping (Thumb, 26 bytes, Stack size 0 bytes, stm32f4xx_hal_cortex.o(i.HAL_NVIC_SetPriorityGrouping))

[Called By]

- >> HAL_Init
- >> HAL_MspInit

HAL_RCC_ClockConfig (Thumb, 308 bytes, Stack size 32 bytes, stm32f4xx_hal_rcc.o(i.HAL_RCC_ClockConfig))

[Stack]

- Max Depth = 80
- Call Chain = HAL_RCC_ClockConfig ⇒ HAL_RCC_GetSysClockFreq ⇒ __aeabi_uldivmod

[Calls]

- >> HAL_RCC_GetSysClockFreq
- >> HAL_InitTick
- >> HAL_GetTick

[Called By]

- >> SystemClock_Config

HAL_RCC_GetHCLKFreq (Thumb, 6 bytes, Stack size 0 bytes, stm32f4xx_hal_rcc.o(i.HAL_RCC_GetHCLKFreq))

[Called By]

- >> HAL_RCC_GetPCLK2Freq
- >> HAL_RCC_GetPCLK1Freq
- >> main
- >> SystemClock_Config

HAL_RCC_GetPCLK1Freq (Thumb, 22 bytes, Stack size 4 bytes, stm32f4xx_hal_rcc.o(i.HAL_RCC_GetPCLK1Freq))

[Stack]

- Max Depth = 4
- Call Chain = HAL_RCC_GetPCLK1Freq

[Calls]

- >> HAL_RCC_GetHCLKFreq

[Called By]

- >> UART_SetConfig

HAL_RCC_GetPCLK2Freq (Thumb, 22 bytes, Stack size 4 bytes, stm32f4xx_hal_rcc.o(i.HAL_RCC_GetPCLK2Freq))

[Stack]

- Max Depth = 4
- Call Chain = HAL_RCC_GetPCLK2Freq

[Calls]

- >> HAL_RCC_GetHCLKFreq

[Called By]

- >> UART_SetConfig

HAL_RCC_GetSysClockFreq (Thumb, 94 bytes, Stack size 8 bytes, stm32f4xx_hal_rcc.o(i.HAL_RCC_GetSysClockFreq))

[Stack]

- Max Depth = 48
- Call Chain = HAL_RCC_GetSysClockFreq ⇒ __aeabi_uldivmod

[Calls]

- >> __aeabi_uldivmod

[Called By]

- >> HAL_RCC_ClockConfig

HAL_RCC_OscConfig (Thumb, 896 bytes, Stack size 40 bytes, stm32f4xx_hal_rcc.o(i.HAL_RCC_OscConfig))

[Stack]

- Max Depth = 40
- Call Chain = HAL_RCC_OscConfig

[Calls]

- >> HAL_GetTick

[Called By]

- >> SystemClock_Config

HAL_SYSTICK_CLKSourceConfig (Thumb, 28 bytes, Stack size 0 bytes, stm32f4xx_hal_cortex.o(i.HAL_SYSTICK_CLKSourceConfig))

[Called By]

- >> SystemClock_Config

HAL_SYSTICK_Callback (Thumb, 2 bytes, Stack size 0 bytes, stm32f4xx_hal_cortex.o(i.HAL_SYSTICK_Callback))

[Called By]

- >> HAL_SYSTICK_IRQHandler

HAL_SYSTICK_Config (Thumb, 40 bytes, Stack size 8 bytes, stm32f4xx_hal_cortex.o(i.HAL_SYSTICK_Config))

[Stack]

- Max Depth = 8
- Call Chain = HAL_SYSTICK_Config

[Calls]

- >> NVIC_SetPriority

[Called By]

- >> HAL_InitTick
- >> SystemClock_Config

HAL_SYSTICK_IRQHandler (Thumb, 8 bytes, Stack size 8 bytes, stm32f4xx_hal_cortex.o(i.HAL_SYSTICK_IRQHandler))

[Stack]

- Max Depth = 8
- Call Chain = HAL_SYSTICK_IRQHandler

[Calls]

- >> HAL_SYSTICK_Callback

[Called By]

- >> SysTick_Handler

HAL_TIMEx_BreakCallback (Thumb, 2 bytes, Stack size 0 bytes, stm32f4xx_hal_tim_ex.o(i.HAL_TIMEx_BreakCallback))

[Called By]

- >> HAL_TIM_IRQHandler

HAL_TIMEx_CommutationCallback (Thumb, 2 bytes, Stack size 0 bytes, stm32f4xx_hal_tim_ex.o(i.HAL_TIMEx_CommutationCallback))

[Called By]

- >> HAL_TIM_IRQHandler

HAL_TIMEx_MasterConfigSynchronization (Thumb, 80 bytes, Stack size 12 bytes, stm32f4xx_hal_tim_ex.o(i.HAL_TIMEx_MasterConfigSynchronization))

[Stack]

- Max Depth = 12
- Call Chain = HAL_TIMEx_MasterConfigSynchronization

[Called By]

- >> MX_TIM5_Init
- >> MX_TIM4_Init
- >> MX_TIM3_Init

HAL_TIM_Base_Init (Thumb, 56 bytes, Stack size 8 bytes, stm32f4xx_hal_tim.o(i.HAL_TIM_Base_Init))

[Stack]

- Max Depth = 32
- Call Chain = HAL_TIM_Base_Init ⇒ TIM_Base_SetConfig

[Calls]

- >> TIM_Base_SetConfig
- >> HAL_TIM_Base_MspInit

[Called By]

- >> MX_TIM5_Init
- >> MX_TIM4_Init
- >> MX_TIM3_Init
- >> MX_TIM14_Init
- >> MX_TIM12_Init

HAL_TIM_Base_MspInit (Thumb, 198 bytes, Stack size 8 bytes, stm32f4xx_hal_msp.o(i.HAL_TIM_Base_MspInit))

[Stack]

- Max Depth = 24
- Call Chain = HAL_TIM_Base_MspInit ⇒ HAL_NVIC_SetPriority

[Calls]

- >> HAL_NVIC_SetPriority
- >> HAL_NVIC_EnableIRQ

[Called By]

- >> HAL_TIM_Base_Init

HAL_TIM_Base_Start_IT (Thumb, 24 bytes, Stack size 0 bytes, stm32f4xx_hal_tim.o(i.HAL_TIM_Base_Start_IT))

[Called By]

- >> main

HAL_TIM_ConfigClockSource (Thumb, 270 bytes, Stack size 16 bytes, stm32f4xx_hal_tim.o(i.HAL_TIM_ConfigClockSource))

[Stack]

- Max Depth = 24
- Call Chain = HAL_TIM_ConfigClockSource ⇒ TIM_TI2_ConfigInputStage

[Calls]

- >> TIM_TI2_ConfigInputStage
- >> TIM_TI1_ConfigInputStage
- >> TIM_ITRx_SetConfig
- >> TIM_ETR_SetConfig

[Called By]

- >> MX_TIM5_Init
- >> MX_TIM4_Init
- >> MX_TIM3_Init
- >> MX_TIM12_Init

HAL_TIM_IC_CaptureCallback (Thumb, 2 bytes, Stack size 0 bytes, stm32f4xx_hal_tim.o(i.HAL_TIM_IC_CaptureCallback))

[Called By]

- >> HAL_TIM_IRQHandler

HAL_TIM_IRQHandler (Thumb, 366 bytes, Stack size 16 bytes, stm32f4xx_hal_tim.o(i.HAL_TIM_IRQHandler))

[Stack]

- Max Depth = 16
- Call Chain = HAL_TIM_IRQHandler

[Calls]

- >> HAL_TIM_TriggerCallback
- >> HAL_TIM_PeriodElapsedCallback
- >> HAL_TIM_PWM_PulseFinishedCallback
- >> HAL_TIM_OC_DelayElapsedCallback
- >> HAL_TIM_IC_CaptureCallback
- >> HAL_TIMEx_CommutationCallback
- >> HAL_TIMEx_BreakCallback

[Called By]

- >> TIM8_TRG_COM_TIM14_IRQHandler
- >> TIM5_IRQHandler
- >> TIM4_IRQHandler
- >> TIM3_IRQHandler

HAL_TIM_MspPostInit (Thumb, 124 bytes, Stack size 32 bytes, stm32f4xx_hal_msp.o(i.HAL_TIM_MspPostInit))

[Stack]

- Max Depth = 72
- Call Chain = HAL_TIM_MspPostInit ⇒ HAL_GPIO_Init

[Calls]

- >> HAL_GPIO_Init

[Called By]

- >> MX_TIM5_Init
- >> MX_TIM4_Init
- >> MX_TIM3_Init
- >> MX_TIM12_Init

HAL_TIM_OC_DelayElapsedCallback (Thumb, 2 bytes, Stack size 0 bytes, stm32f4xx_hal_tim.o(i.HAL_TIM_OC_DelayElapsedCallback))

[Called By]

- >> HAL_TIM_IRQHandler

HAL_TIM_PWM_ConfigChannel (Thumb, 218 bytes, Stack size 16 bytes, stm32f4xx_hal_tim.o(i.HAL_TIM_PWM_ConfigChannel))

[Stack]

- Max Depth = 28
- Call Chain = HAL_TIM_PWM_ConfigChannel ⇒ TIM_OC4_SetConfig

[Calls]

- >> TIM_OC4_SetConfig
- >> TIM_OC3_SetConfig
- >> TIM_OC1_SetConfig
- >> TIM_OC2_SetConfig

[Called By]

- >> MX_TIM5_Init
- >> MX_TIM4_Init
- >> MX_TIM3_Init
- >> MX_TIM12_Init

HAL_TIM_PWM_Init (Thumb, 56 bytes, Stack size 8 bytes, stm32f4xx_hal_tim.o(i.HAL_TIM_PWM_Init))

[Stack]

- Max Depth = 32
- Call Chain = HAL_TIM_PWM_Init ⇒ TIM_Base_SetConfig

[Calls]

- >> HAL_TIM_PWM_MspInit
- >> TIM_Base_SetConfig

[Called By]

- >> MX_TIM5_Init
- >> MX_TIM4_Init
- >> MX_TIM3_Init
- >> MX_TIM12_Init

HAL_TIM_PWM_MspInit (Thumb, 2 bytes, Stack size 0 bytes, stm32f4xx_hal_tim.o(i.HAL_TIM_PWM_MspInit))

[Called By]

- >> HAL_TIM_PWM_Init

HAL_TIM_PWM_PulseFinishedCallback (Thumb, 2 bytes, Stack size 0 bytes, stm32f4xx_hal_tim.o(i.HAL_TIM_PWM_PulseFinishedCallback))

[Called By]

- >> HAL_TIM_IRQHandler

HAL_TIM_PWM_Start (Thumb, 48 bytes, Stack size 8 bytes, stm32f4xx_hal_tim.o(i.HAL_TIM_PWM_Start))

[Stack]

- Max Depth = 16
- Call Chain = HAL_TIM_PWM_Start ⇒ TIM_CCxChannelCmd

[Calls]

- >> TIM_CCxChannelCmd

[Called By]

- >> main
- >> Grap_object
- >> ExecuteController

HAL_TIM_PWM_Stop (Thumb, 84 bytes, Stack size 8 bytes, stm32f4xx_hal_tim.o(i.HAL_TIM_PWM_Stop))

[Stack]

- Max Depth = 16
- Call Chain = HAL_TIM_PWM_Stop ⇒ TIM_CCxChannelCmd

[Calls]

- >> TIM_CCxChannelCmd

[Called By]

- >> Set_Home
- >> Stepper_PulseTimerUpdate

HAL_TIM_PeriodElapsedCallback (Thumb, 2 bytes, Stack size 0 bytes, stm32f4xx_hal_tim.o(i.HAL_TIM_PeriodElapsedCallback))

[Called By]

- >> HAL_TIM_IRQHandler

HAL_TIM_TriggerCallback (Thumb, 2 bytes, Stack size 0 bytes, stm32f4xx_hal_tim.o(i.HAL_TIM_TriggerCallback))

[Called By]

- >> HAL_TIM_IRQHandler

HAL_UART_ErrorCallback (Thumb, 2 bytes, Stack size 0 bytes, stm32f4xx_hal_uart.o(i.HAL_UART_ErrorCallback))

[Called By]

- >> HAL_UART_IRQHandler
- >> UART_DMAError
- >> UART_DMAAbortOnError

HAL_UART_IRQHandler (Thumb, 268 bytes, Stack size 16 bytes, stm32f4xx_hal_uart.o(i.HAL_UART_IRQHandler))

[Stack]

- Max Depth = 240
- Call Chain = HAL_UART_IRQHandler ⇒ UART_Receive_IT ⇒ HAL_UART_RxCpltCallback ⇒ Serial_RxCallback ⇒ Decode ⇒ DecodeParam ⇒ DecodeValue ⇒ ExecuteRequest ⇒ SetParamValue ⇒ Stepper_SetMinSPS ⇒ Stepper_SaveConfig ⇒ HAL_FLASH_Program ⇒ FLASH_WaitForLastOperation

[Calls]

- >> HAL_UART_ErrorCallback
- >> HAL_DMA_Abort_IT
- >> UART_Transmit_IT
- >> UART_Receive_IT
- >> UART_EndTransmit_IT
- >> UART_EndRxTransfer

[Called By]

- >> UART4_IRQHandler

HAL_UART_Init (Thumb, 100 bytes, Stack size 16 bytes, stm32f4xx_hal_uart.o(i.HAL_UART_Init))

[Stack]

- Max Depth = 104
- Call Chain = HAL_UART_Init ⇒ HAL_UART_MspInit ⇒ HAL_GPIO_Init

[Calls]

- >> UART_SetConfig
- >> HAL_UART_MspInit

[Called By]

- >> MX_UART4_Init

HAL_UART_MspInit (Thumb, 190 bytes, Stack size 48 bytes, stm32f4xx_hal_msp.o(i.HAL_UART_MspInit))

[Stack]

- Max Depth = 88
- Call Chain = HAL_UART_MspInit ⇒ HAL_GPIO_Init

[Calls]

- >> HAL_NVIC_SetPriority
- >> HAL_NVIC_EnableIRQ
- >> HAL_DMA_Init
- >> HAL_GPIO_Init
- >> _Error_Handler

[Called By]

- >> HAL_UART_Init

HAL_UART_Receive_DMA (Thumb, 142 bytes, Stack size 32 bytes, stm32f4xx_hal_uart.o(i.HAL_UART_Receive_DMA))

[Stack]

- Max Depth = 68
- Call Chain = HAL_UART_Receive_DMA ⇒ HAL_DMA_Start_IT ⇒ DMA_SetConfig

[Calls]

- >> HAL_DMA_Start_IT

[Called By]

- >> Serial_InitRxSequence

HAL_UART_RxCpltCallback (Thumb, 52 bytes, Stack size 16 bytes, serial.o(i.HAL_UART_RxCpltCallback))

[Stack]

- Max Depth = 216
- Call Chain = HAL_UART_RxCpltCallback ⇒ Serial_RxCallback ⇒ Decode ⇒ DecodeParam ⇒ DecodeValue ⇒ ExecuteRequest ⇒ SetParamValue ⇒ Stepper_SetMinSPS ⇒ Stepper_SaveConfig ⇒ HAL_FLASH_Program ⇒ FLASH_WaitForLastOperation

[Calls]

- >> Serial_RxCallback
- >> Serial_InitRxSequence

[Called By]

- >> UART_Receive_IT
- >> UART_DMAReceiveCplt

HAL_UART_RxHalfCpltCallback (Thumb, 2 bytes, Stack size 0 bytes, stm32f4xx_hal_uart.o(i.HAL_UART_RxHalfCpltCallback))

[Called By]

- >> UART_DMARxHalfCplt

HAL_UART_Transmit_DMA (Thumb, 126 bytes, Stack size 32 bytes, stm32f4xx_hal_uart.o(i.HAL_UART_Transmit_DMA))

[Stack]

- Max Depth = 68
- Call Chain = HAL_UART_Transmit_DMA ⇒ HAL_DMA_Start_IT ⇒ DMA_SetConfig

[Calls]

- >> HAL_DMA_Start_IT

[Called By]

- >> Serial_ExecutePendingTransmits
- >> HAL_UART_TxCpltCallback

HAL_UART_TxCpltCallback (Thumb, 96 bytes, Stack size 16 bytes, serial.o(i.HAL_UART_TxCpltCallback))

[Stack]

- Max Depth = 108
- Call Chain = HAL_UART_TxCpltCallback ⇒ Serial_ExecutePendingTransmits ⇒ HAL_UART_Transmit_DMA ⇒ HAL_DMA_Start_IT ⇒ DMA_SetConfig

[Calls]

- >> HAL_UART_Transmit_DMA
- >> Serial_ExecutePendingTransmits
- >> strlen

[Called By]

- >> UART_EndTransmit_IT
- >> UART_DMATransmitCplt

HAL_UART_TxHalfCpltCallback (Thumb, 2 bytes, Stack size 0 bytes, stm32f4xx_hal_uart.o(i.HAL_UART_TxHalfCpltCallback))

[Called By]

- >> UART_DMATxHalfCplt

HardFault_Handler (Thumb, 2 bytes, Stack size 0 bytes, stm32f4xx_it.o(i.HardFault_Handler))

[Calls]

- >> HardFault_Handler

[Called By]

- >> HardFault_Handler

[Address Reference Count : 1]

- startup_stm32f407xx.o(RESET)

IncrementSPS (Thumb, 22 bytes, Stack size 0 bytes, steppercontroller.o(i.IncrementSPS))

[Stack]

- Max Depth = 8
- Call Chain = IncrementSPS ⇒ SetStepTimerByCurrentSPS

[Calls]

- >> SetStepTimerByCurrentSPS

[Called By]

- >> ExecuteController

MemManage_Handler (Thumb, 2 bytes, Stack size 0 bytes, stm32f4xx_it.o(i.MemManage_Handler))

[Calls]

- >> MemManage_Handler

[Called By]

- >> MemManage_Handler

[Address Reference Count : 1]

- startup_stm32f407xx.o(RESET)

NMI_Handler (Thumb, 2 bytes, Stack size 0 bytes, stm32f4xx_it.o(i.NMI_Handler))
[Address Reference Count : 1]

- startup_stm32f407xx.o(RESET)

PendSV_Handler (Thumb, 2 bytes, Stack size 0 bytes, stm32f4xx_it.o(i.PendSV_Handler))
[Address Reference Count : 1]

- startup_stm32f407xx.o(RESET)

PrintStepperStatusStr (Thumb, 92 bytes, Stack size 8 bytes, steppercommands.o(i.PrintStepperStatusStr))

[Stack]

- Max Depth = 32
- Call Chain = PrintStepperStatusStr ⇒ __2printf

[Calls]

- >> __2printf

[Called By]

- >> ExecuteRequest

SVC_Handler (Thumb, 2 bytes, Stack size 0 bytes, stm32f4xx_it.o(i.SVC_Handler))
[Address Reference Count : 1]

- startup_stm32f407xx.o(RESET)

Serial_CheckRxTimeout (Thumb, 46 bytes, Stack size 16 bytes, serial.o(i.Serial_CheckRxTimeout))

[Stack]

- Max Depth = 216
- Call Chain = Serial_CheckRxTimeout ⇒ Serial_RxCallback ⇒ Decode ⇒ DecodeParam ⇒ DecodeValue ⇒ ExecuteRequest ⇒ SetParamValue ⇒ Stepper_SetMinSPS ⇒ Stepper_SaveConfig ⇒ HAL_FLASH_Program ⇒ FLASH_WaitForLastOperation

[Calls]

- >> Serial_RxCallback

[Called By]

- >> TIM8_TRG_COM_TIM14_IRQHandler

Serial_ExecutePendingTransmits (Thumb, 124 bytes, Stack size 24 bytes, serial.o(i.Serial_ExecutePendingTransmits))

[Stack]

- Max Depth = 92
- Call Chain = Serial_ExecutePendingTransmits ⇒ HAL_UART_Transmit_DMA ⇒ HAL_DMA_Start_IT ⇒ DMA_SetConfig

[Calls]

- >> HAL_UART_Transmit_DMA

[Called By]

- >> fputc
- >> HAL_UART_TxCpltCallback

Serial_InitRxSequence (Thumb, 42 bytes, Stack size 16 bytes, serial.o(i.Serial_InitRxSequence))

[Stack]

- Max Depth = 84
- Call Chain = Serial_InitRxSequence ⇒ HAL_UART_Receive_DMA ⇒ HAL_DMA_Start_IT ⇒ DMA_SetConfig

[Calls]

- >> HAL_UART_Receive_DMA

[Called By]

- >> main
- >> HAL_UART_RxCpltCallback

Serial_RxCallback (Thumb, 4 bytes, Stack size 0 bytes, steppercommands.o(i.Serial_RxCallback))

[Stack]

- Max Depth = 200
- Call Chain = Serial_RxCallback ⇒ Decode ⇒ DecodeParam ⇒ DecodeValue ⇒ ExecuteRequest ⇒ SetParamValue ⇒ Stepper_SetMinSPS ⇒ Stepper_SaveConfig ⇒ HAL_FLASH_Program ⇒ FLASH_WaitForLastOperation

[Calls]

- >> Decode

[Called By]

- >> Serial_CheckRxTimeout
- >> HAL_UART_RxCpltCallback

SetAccelerationByMinSPS (Thumb, 162 bytes, Stack size 12 bytes, steppercontroller.o(i.SetAccelerationByMinSPS))

[Stack]

- Max Depth = 12
- Call Chain = SetAccelerationByMinSPS

[Called By]

- >> Stepper_SetMinSPS
- >> Stepper_SetMaxSPS
- >> Stepper_InitDefaultState

SetParamValue (Thumb, 146 bytes, Stack size 16 bytes, steppercommands.o(i.SetParamValue))

[Stack]

- Max Depth = 104
- Call Chain = SetParamValue ⇒ Stepper_SetMinSPS ⇒ Stepper_SaveConfig ⇒ HAL_FLASH_Program ⇒ FLASH_WaitForLastOperation

[Calls]

- >> HAL_GPIO_WritePin
- >> Stepper_SetTargetPosition
- >> Stepper_SetMinSPS
- >> Stepper_SetMaxSPS
- >> Stepper_SetCurrentPosition

[Called By]

- >> ExecuteRequest

SetStepTimerByCurrentSPS (Thumb, 82 bytes, Stack size 8 bytes, steppercontroller.o(i.SetStepTimerByCurrentSPS))

[Stack]

- Max Depth = 8
- Call Chain = SetStepTimerByCurrentSPS

[Called By]

- >> Stepper_SetMinSPS
- >> Stepper_SetMaxSPS
- >> Stepper_LoadConfig
- >> Stepper_InitDefaultState
- >> IncrementSPS
- >> DecrementSPS

Set_Home (Thumb, 118 bytes, Stack size 24 bytes, main.o(i.Set_Home))

[Stack]

- Max Depth = 40
- Call Chain = Set_Home ⇒ HAL_TIM_PWM_Stop ⇒ TIM_CCxChannelCmd

[Calls]

- >> HAL_GPIO_WritePin
- >> HAL_GPIO_ReadPin
- >> HAL_TIM_PWM_Stop

[Called By]

- >> main
- >> ExecuteRequest

Set_Orient (Thumb, 40 bytes, Stack size 0 bytes, main.o(i.Set_Orient))

[Called By]

- >> ExecuteRequest

Stepper_ExecuteAllControllers (Thumb, 34 bytes, Stack size 16 bytes, steppercontroller.o(i.Stepper_ExecuteAllControllers))

[Stack]

- Max Depth = 60
- Call Chain = Stepper_ExecuteAllControllers ⇒ ExecuteController ⇒ __aeabi_l2f ⇒ _float_epilogue

[Calls]

- >> ExecuteController

[Called By]

- >> TIM8_TRG_COM_TIM14_IRQHandler

Stepper_GetAccPrescaler (Thumb, 16 bytes, Stack size 4 bytes, steppercontroller.o(i.Stepper_GetAccPrescaler))

[Stack]

- Max Depth = 4
- Call Chain = Stepper_GetAccPrescaler

[Calls]

- >> GetState

[Called By]

- >> GetParamValue

Stepper_GetAccSPS (Thumb, 16 bytes, Stack size 4 bytes, steppercontroller.o(i.Stepper_GetAccSPS))

[Stack]

- Max Depth = 4
- Call Chain = Stepper_GetAccSPS

[Calls]

- >> GetState

[Called By]

- >> GetParamValue

Stepper_GetCurrentPosition (Thumb, 16 bytes, Stack size 4 bytes, steppercontroller.o(i.Stepper_GetCurrentPosition))

[Stack]

- Max Depth = 4
- Call Chain = Stepper_GetCurrentPosition

[Calls]

- >> GetState

[Called By]

- >> Calib_Home
- >> GetParamValue

Stepper_GetCurrentSPS (Thumb, 16 bytes, Stack size 4 bytes, steppercontroller.o(i.Stepper_GetCurrentSPS))

[Stack]

- Max Depth = 4
- Call Chain = Stepper_GetCurrentSPS

[Calls]

- >> GetState

[Called By]

- >> GetParamValue

Stepper_GetMaxSPS (Thumb, 16 bytes, Stack size 4 bytes, steppercontroller.o(i.Stepper_GetMaxSPS))

[Stack]

- Max Depth = 4
- Call Chain = Stepper_GetMaxSPS

[Calls]

- >> GetState

[Called By]

- >> GetParamValue

Stepper_GetMinSPS (Thumb, 16 bytes, Stack size 4 bytes, steppercontroller.o(i.Stepper_GetMinSPS))

[Stack]

- Max Depth = 4
- Call Chain = Stepper_GetMinSPS

[Calls]

- >> GetState

[Called By]

- >> GetParamValue

Stepper_GetStatus (Thumb, 18 bytes, Stack size 4 bytes, steppercontroller.o(i.Stepper_GetStatus))

[Stack]

- Max Depth = 4
- Call Chain = Stepper_GetStatus

[Calls]

- >> GetState

[Called By]

- >> Calib_Home
- >> GetParamValue
- >> ExecuteRequest
- >> DecodeStepper

Stepper_GetTargetPosition (Thumb, 16 bytes, Stack size 4 bytes, steppercontroller.o(i.Stepper_GetTargetPosition))

[Stack]

- Max Depth = 4
- Call Chain = Stepper_GetTargetPosition

[Calls]

- >> GetState

[Called By]

- >> GetParamValue

Stepper_InitDefaultState (Thumb, 102 bytes, Stack size 12 bytes, steppercontroller.o(i.Stepper_InitDefaultState))

[Stack]

- Max Depth = 24
- Call Chain = Stepper_InitDefaultState ⇒ SetAccelerationByMinSPS

[Calls]

- >> SetStepTimerByCurrentSPS
- >> SetAccelerationByMinSPS
- >> GetState

[Called By]

- >> main
- >> ExecuteRequest

Stepper_LoadConfig (Thumb, 56 bytes, Stack size 16 bytes, steppercontroller.o(i.Stepper_LoadConfig))

[Stack]

- Max Depth = 24
- Call Chain = Stepper_LoadConfig ⇒ SetStepTimerByCurrentSPS

[Calls]

- >> SetStepTimerByCurrentSPS

[Called By]

- >> main

Stepper_PulseTimerUpdate (Thumb, 166 bytes, Stack size 16 bytes, steppercontroller.o(i.Stepper_PulseTimerUpdate))

[Stack]

- Max Depth = 40
- Call Chain = Stepper_PulseTimerUpdate ⇒ __2printf

[Calls]

- >> HAL_TIM_PWM_Stop
- >> GetStepsToTarget
- >> GetStepDirectionUnit
- >> GetState
- >> __2printf

[Called By]

- >> TIM5_IRQHandler
- >> TIM4_IRQHandler
- >> TIM3_IRQHandler

Stepper_SaveConfig (Thumb, 112 bytes, Stack size 24 bytes, steppercontroller.o(i.Stepper_SaveConfig))

[Stack]

- Max Depth = 72
- Call Chain = Stepper_SaveConfig ⇒ HAL_FLASH_Program ⇒ FLASH_WaitForLastOperation

[Calls]

- >> FLASH_Erase_Sector
- >> HAL_FLASH_Unlock
- >> HAL_FLASH_Program
- >> HAL_FLASH_Lock

[Called By]

- >> main
- >> ExecuteRequest
- >> Stepper_SetMinSPS
- >> Stepper_SetMaxSPS
- >> Stepper_SetAccSPS
- >> Stepper_SetAccPrescaler

Stepper_SetAccPrescaler (Thumb, 54 bytes, Stack size 8 bytes, steppercontroller.o(i.Stepper_SetAccPrescaler))

[Stack]

- Max Depth = 80
- Call Chain = Stepper_SetAccPrescaler ⇒ Stepper_SaveConfig ⇒ HAL_FLASH_Program ⇒ FLASH_WaitForLastOperation

[Calls]

- >> Stepper_SaveConfig
- >> GetState

[Called By]

- >> main

Stepper_SetAccSPS (Thumb, 66 bytes, Stack size 16 bytes, steppercontroller.o(i.Stepper_SetAccSPS))

[Stack]

- Max Depth = 88
- Call Chain = Stepper_SetAccSPS ⇒ Stepper_SaveConfig ⇒ HAL_FLASH_Program ⇒ FLASH_WaitForLastOperation

[Calls]

- >> Stepper_SaveConfig
- >> GetState

[Called By]

- >> main

Stepper_SetCurrentPosition (Thumb, 34 bytes, Stack size 8 bytes, steppercontroller.o(i.Stepper_SetCurrentPosition))

[Stack]

- Max Depth = 8
- Call Chain = Stepper_SetCurrentPosition

[Calls]

- >> GetState

[Called By]

- >> main
- >> Calib_Home
- >> SetParamValue
- >> ExecuteRequest

Stepper_SetMaxSPS (Thumb, 94 bytes, Stack size 16 bytes, steppercontroller.o(i.Stepper_SetMaxSPS))

[Stack]

- Max Depth = 88
- Call Chain = Stepper_SetMaxSPS ⇒ Stepper_SaveConfig ⇒ HAL_FLASH_Program ⇒ FLASH_WaitForLastOperation

[Calls]

- >> Stepper_SaveConfig
- >> SetStepTimerByCurrentSPS
- >> SetAccelerationByMinSPS
- >> GetState

[Called By]

- >> SetParamValue
- >> ExecuteRequest

Stepper_SetMinSPS (Thumb, 98 bytes, Stack size 16 bytes, steppercontroller.o(i.Stepper_SetMinSPS))

[Stack]

- Max Depth = 88
- Call Chain = Stepper_SetMinSPS ⇒ Stepper_SaveConfig ⇒ HAL_FLASH_Program ⇒ FLASH_WaitForLastOperation

[Calls]

- >> Stepper_SaveConfig
- >> SetStepTimerByCurrentSPS
- >> SetAccelerationByMinSPS
- >> GetState

[Called By]

- >> SetParamValue
- >> ExecuteRequest

Stepper_SetTargetPosition (Thumb, 20 bytes, Stack size 8 bytes, steppercontroller.o(i.Stepper_SetTargetPosition))

[Stack]

- Max Depth = 8
- Call Chain = Stepper_SetTargetPosition

[Calls]

- >> GetState

[Called By]

- >> Calib_Home
- >> SetParamValue

Stepper_SetupPeripherals (Thumb, 96 bytes, Stack size 24 bytes, steppercontroller.o(i.Stepper_SetupPeripherals))

[Stack]

- Max Depth = 24
- Call Chain = Stepper_SetupPeripherals

[Calls]

- >> GetState

[Called By]

- >> main

SysTick_Handler (Thumb, 14 bytes, Stack size 8 bytes, stm32f4xx_it.o(i.SysTick_Handler))

[Stack]

- Max Depth = 16
- Call Chain = SysTick_Handler ⇒ HAL_SYSTICK_IRQHandler

[Calls]

- >> HAL_SYSTICK_IRQHandler
- >> HAL_IncTick

[Address Reference Count : 1]

- startup_stm32f407xx.o(RESET)

SystemClock_Config (Thumb, 168 bytes, Stack size 88 bytes, main.o(i.SystemClock_Config))

[Stack]

- Max Depth = 168
- Call Chain = SystemClock_Config ⇒ HAL_RCC_ClockConfig ⇒ HAL_RCC_GetSysClockFreq ⇒ __aeabi_uldivmod

[Calls]

- >> HAL_SYSTICK_Config
- >> HAL_SYSTICK_CLKSourceConfig
- >> HAL_NVIC_SetPriority
- >> HAL_RCC_OscConfig
- >> HAL_RCC_GetHCLKFreq
- >> HAL_RCC_ClockConfig
- >> _Error_Handler

[Called By]

- >> main

SystemInit (Thumb, 66 bytes, Stack size 0 bytes, system_stm32f4xx_1.o(i.SystemInit))
[Address Reference Count : 1]

- startup_stm32f407xx.o(.text)

TIM3_IRQHandler (Thumb, 40 bytes, Stack size 8 bytes, stm32f4xx_it.o(i.TIM3_IRQHandler))

[Stack]

- Max Depth = 48
- Call Chain = TIM3_IRQHandler ⇒ Stepper_PulseTimerUpdate ⇒ __2printf

[Calls]

- >> HAL_TIM_IRQHandler
- >> Stepper_PulseTimerUpdate

[Address Reference Count : 1]

- startup_stm32f407xx.o(RESET)

TIM4_IRQHandler (Thumb, 40 bytes, Stack size 8 bytes, stm32f4xx_it.o(i.TIM4_IRQHandler))

[Stack]

- Max Depth = 48
- Call Chain = TIM4_IRQHandler ⇒ Stepper_PulseTimerUpdate ⇒ __2printf

[Calls]

- >> HAL_TIM_IRQHandler
- >> Stepper_PulseTimerUpdate

[Address Reference Count : 1]

- startup_stm32f407xx.o(RESET)

TIM5_IRQHandler (Thumb, 40 bytes, Stack size 8 bytes, stm32f4xx_it.o(i.TIM5_IRQHandler))

[Stack]

- Max Depth = 48
- Call Chain = TIM5_IRQHandler ⇒ Stepper_PulseTimerUpdate ⇒ __2printf

[Calls]

- >> HAL_TIM_IRQHandler
- >> Stepper_PulseTimerUpdate

[Address Reference Count : 1]

- startup_stm32f407xx.o(RESET)

TIM8_TRG_COM_TIM14_IRQHandler (Thumb, 42 bytes, Stack size 8 bytes, stm32f4xx_it.o(i.TIM8_TRG_COM_TIM14_IRQHandler))

[Stack]

- Max Depth = 224
- Call Chain = TIM8_TRG_COM_TIM14_IRQHandler ⇒ Serial_CheckRxTimeout ⇒ Serial_RxCallback ⇒ Decode ⇒ DecodeParam ⇒ DecodeValue ⇒ ExecuteRequest ⇒ SetParamValue ⇒ Stepper_SetMinSPS ⇒ Stepper_SaveConfig ⇒ HAL_FLASH_Program ⇒ FLASH_WaitForLastOperation

[Calls]

- >> HAL_TIM_IRQHandler
- >> Serial_CheckRxTimeout
- >> Stepper_ExecuteAllControllers

[Address Reference Count : 1]

- startup_stm32f407xx.o(RESET)

TIM_Base_SetConfig (Thumb, 152 bytes, Stack size 24 bytes, stm32f4xx_hal_tim.o(i.TIM_Base_SetConfig))

[Stack]

- Max Depth = 24
- Call Chain = TIM_Base_SetConfig

[Called By]

- >> HAL_TIM_Base_Init
- >> HAL_TIM_PWM_Init

TIM_CCxChannelCmd (Thumb, 22 bytes, Stack size 8 bytes, stm32f4xx_hal_tim.o(i.TIM_CCxChannelCmd))

[Stack]

- Max Depth = 8
- Call Chain = TIM_CCxChannelCmd

[Called By]

- >> HAL_TIM_PWM_Stop
- >> HAL_TIM_PWM_Start

TIM_OC2_SetConfig (Thumb, 98 bytes, Stack size 12 bytes, stm32f4xx_hal_tim.o(i.TIM_OC2_SetConfig))

[Stack]

- Max Depth = 12
- Call Chain = TIM_OC2_SetConfig

[Called By]

- >> HAL_TIM_PWM_ConfigChannel

UART4_IRQHandler (Thumb, 6 bytes, Stack size 0 bytes, stm32f4xx_it.o(i.UART4_IRQHandler))

[Stack]

- Max Depth = 240
- Call Chain = UART4_IRQHandler ⇒ HAL_UART_IRQHandler ⇒ UART_Receive_IT ⇒ HAL_UART_RxCpltCallback ⇒ Serial_RxCallback ⇒ Decode ⇒ DecodeParam ⇒ DecodeValue ⇒ ExecuteRequest ⇒ SetParamValue ⇒ Stepper_SetMinSPS ⇒ Stepper_SaveConfig ⇒ HAL_FLASH_Program ⇒ FLASH_WaitForLastOperation

[Calls]

- >> HAL_UART_IRQHandler

[Address Reference Count : 1]

- startup_stm32f407xx.o(RESET)

UsageFault_Handler (Thumb, 2 bytes, Stack size 0 bytes, stm32f4xx_it.o(i.UsageFault_Handler))

[Calls]

- >> UsageFault_Handler

[Called By]

- >> UsageFault_Handler

[Address Reference Count : 1]

- startup_stm32f407xx.o(RESET)

_Error_Handler (Thumb, 2 bytes, Stack size 0 bytes, main.o(i._Error_Handler))

[Calls]

- >> _Error_Handler

[Called By]

- >> _Error_Handler
- >> SystemClock_Config
- >> MX_UART4_Init
- >> MX_TIM5_Init
- >> MX_TIM4_Init
- >> MX_TIM3_Init
- >> MX_TIM14_Init
- >> MX_TIM12_Init
- >> HAL_UART_MspInit

__0printf$5 (Thumb, 22 bytes, Stack size 24 bytes, printf5.o(i.__0printf$5), UNUSED)

[Calls]

- >> _printf_core

__1printf$5 (Thumb, 0 bytes, Stack size 24 bytes, printf5.o(i.__0printf$5), UNUSED)

__2printf (Thumb, 0 bytes, Stack size 24 bytes, printf5.o(i.__0printf$5))

[Stack]

- Max Depth = 24
- Call Chain = __2printf

[Called By]

- >> main
- >> PrintStepperStatusStr
- >> ExecuteRequest
- >> Stepper_PulseTimerUpdate

__scatterload_copy (Thumb, 14 bytes, Stack size unknown bytes, handlers.o(i.__scatterload_copy), UNUSED)

__scatterload_null (Thumb, 2 bytes, Stack size unknown bytes, handlers.o(i.__scatterload_null), UNUSED)

__scatterload_zeroinit (Thumb, 14 bytes, Stack size unknown bytes, handlers.o(i.__scatterload_zeroinit), UNUSED)

fputc (Thumb, 62 bytes, Stack size 8 bytes, serial.o(i.fputc))

[Stack]

- Max Depth = 100
- Call Chain = fputc ⇒ Serial_ExecutePendingTransmits ⇒ HAL_UART_Transmit_DMA ⇒ HAL_DMA_Start_IT ⇒ DMA_SetConfig

[Calls]

- >> Serial_ExecutePendingTransmits

[Address Reference Count : 1]

- printf5.o(i.__0printf$5)

main (Thumb, 448 bytes, Stack size 32 bytes, main.o(i.main))

[Stack]

- Max Depth = 200
- Call Chain = main ⇒ SystemClock_Config ⇒ HAL_RCC_ClockConfig ⇒ HAL_RCC_GetSysClockFreq ⇒ __aeabi_uldivmod

[Calls]

- >> HAL_TIM_Base_Start_IT
- >> HAL_GPIO_WritePin
- >> HAL_RCC_GetHCLKFreq
- >> HAL_TIM_PWM_Start
- >> SystemClock_Config
- >> Calib_Home
- >> MX_UART4_Init
- >> MX_TIM5_Init
- >> MX_TIM4_Init
- >> MX_TIM3_Init
- >> MX_TIM14_Init
- >> MX_TIM12_Init
- >> MX_GPIO_Init
- >> MX_DMA_Init
- >> Set_Home
- >> ExecuteRequest
- >> Serial_InitRxSequence
- >> Stepper_SetupPeripherals
- >> Stepper_SetCurrentPosition
- >> Stepper_SetAccSPS
- >> Stepper_SetAccPrescaler
- >> Stepper_SaveConfig
- >> Stepper_LoadConfig
- >> Stepper_InitDefaultState
- >> HAL_Delay
- >> HAL_Init
- >> __2printf
- >> __aeabi_memcpy4

[Address Reference Count : 1]

- entry9a.o(.ARM.Collect$$$$0000000B)

### Local Symbols

TIM_ETR_SetConfig (Thumb, 20 bytes, Stack size 8 bytes, stm32f4xx_hal_tim.o(i.TIM_ETR_SetConfig))

[Stack]

- Max Depth = 8
- Call Chain = TIM_ETR_SetConfig

[Called By]

- >> HAL_TIM_ConfigClockSource

TIM_ITRx_SetConfig (Thumb, 16 bytes, Stack size 0 bytes, stm32f4xx_hal_tim.o(i.TIM_ITRx_SetConfig))

[Called By]

- >> HAL_TIM_ConfigClockSource

TIM_OC1_SetConfig (Thumb, 88 bytes, Stack size 12 bytes, stm32f4xx_hal_tim.o(i.TIM_OC1_SetConfig))

[Stack]

- Max Depth = 12
- Call Chain = TIM_OC1_SetConfig

[Called By]

- >> HAL_TIM_PWM_ConfigChannel

TIM_OC3_SetConfig (Thumb, 96 bytes, Stack size 12 bytes, stm32f4xx_hal_tim.o(i.TIM_OC3_SetConfig))

[Stack]

- Max Depth = 12
- Call Chain = TIM_OC3_SetConfig

[Called By]

- >> HAL_TIM_PWM_ConfigChannel

TIM_OC4_SetConfig (Thumb, 74 bytes, Stack size 12 bytes, stm32f4xx_hal_tim.o(i.TIM_OC4_SetConfig))

[Stack]

- Max Depth = 12
- Call Chain = TIM_OC4_SetConfig

[Called By]

- >> HAL_TIM_PWM_ConfigChannel

TIM_TI1_ConfigInputStage (Thumb, 34 bytes, Stack size 8 bytes, stm32f4xx_hal_tim.o(i.TIM_TI1_ConfigInputStage))

[Stack]

- Max Depth = 8
- Call Chain = TIM_TI1_ConfigInputStage

[Called By]

- >> HAL_TIM_ConfigClockSource

TIM_TI2_ConfigInputStage (Thumb, 36 bytes, Stack size 8 bytes, stm32f4xx_hal_tim.o(i.TIM_TI2_ConfigInputStage))

[Stack]

- Max Depth = 8
- Call Chain = TIM_TI2_ConfigInputStage

[Called By]

- >> HAL_TIM_ConfigClockSource

UART_DMAAbortOnError (Thumb, 16 bytes, Stack size 8 bytes, stm32f4xx_hal_uart.o(i.UART_DMAAbortOnError))

[Stack]

- Max Depth = 8
- Call Chain = UART_DMAAbortOnError

[Calls]

- >> HAL_UART_ErrorCallback

[Address Reference Count : 1]

- stm32f4xx_hal_uart.o(i.HAL_UART_IRQHandler)

UART_DMAError (Thumb, 74 bytes, Stack size 16 bytes, stm32f4xx_hal_uart.o(i.UART_DMAError))

[Stack]

- Max Depth = 16
- Call Chain = UART_DMAError

[Calls]

- >> HAL_UART_ErrorCallback
- >> UART_EndTxTransfer
- >> UART_EndRxTransfer

[Address Reference Count : 2]

- stm32f4xx_hal_uart.o(i.HAL_UART_Receive_DMA)
- stm32f4xx_hal_uart.o(i.HAL_UART_Transmit_DMA)

UART_DMAReceiveCplt (Thumb, 60 bytes, Stack size 8 bytes, stm32f4xx_hal_uart.o(i.UART_DMAReceiveCplt))

[Stack]

- Max Depth = 224
- Call Chain = UART_DMAReceiveCplt ⇒ HAL_UART_RxCpltCallback ⇒ Serial_RxCallback ⇒ Decode ⇒ DecodeParam ⇒ DecodeValue ⇒ ExecuteRequest ⇒ SetParamValue ⇒ Stepper_SetMinSPS ⇒ Stepper_SaveConfig ⇒ HAL_FLASH_Program ⇒ FLASH_WaitForLastOperation

[Calls]

- >> HAL_UART_RxCpltCallback

[Address Reference Count : 1]

- stm32f4xx_hal_uart.o(i.HAL_UART_Receive_DMA)

UART_DMARxHalfCplt (Thumb, 10 bytes, Stack size 8 bytes, stm32f4xx_hal_uart.o(i.UART_DMARxHalfCplt))

[Stack]

- Max Depth = 8
- Call Chain = UART_DMARxHalfCplt

[Calls]

- >> HAL_UART_RxHalfCpltCallback

[Address Reference Count : 1]

- stm32f4xx_hal_uart.o(i.HAL_UART_Receive_DMA)

UART_DMATransmitCplt (Thumb, 46 bytes, Stack size 8 bytes, stm32f4xx_hal_uart.o(i.UART_DMATransmitCplt))

[Stack]

- Max Depth = 116
- Call Chain = UART_DMATransmitCplt ⇒ HAL_UART_TxCpltCallback ⇒ Serial_ExecutePendingTransmits ⇒ HAL_UART_Transmit_DMA ⇒ HAL_DMA_Start_IT ⇒ DMA_SetConfig

[Calls]

- >> HAL_UART_TxCpltCallback

[Address Reference Count : 1]

- stm32f4xx_hal_uart.o(i.HAL_UART_Transmit_DMA)

UART_DMATxHalfCplt (Thumb, 10 bytes, Stack size 8 bytes, stm32f4xx_hal_uart.o(i.UART_DMATxHalfCplt))

[Stack]

- Max Depth = 8
- Call Chain = UART_DMATxHalfCplt

[Calls]

- >> HAL_UART_TxHalfCpltCallback

[Address Reference Count : 1]

- stm32f4xx_hal_uart.o(i.HAL_UART_Transmit_DMA)

UART_EndRxTransfer (Thumb, 28 bytes, Stack size 0 bytes, stm32f4xx_hal_uart.o(i.UART_EndRxTransfer))

[Called By]

- >> HAL_UART_IRQHandler
- >> UART_DMAError

UART_EndTransmit_IT (Thumb, 26 bytes, Stack size 8 bytes, stm32f4xx_hal_uart.o(i.UART_EndTransmit_IT))

[Stack]

- Max Depth = 116
- Call Chain = UART_EndTransmit_IT ⇒ HAL_UART_TxCpltCallback ⇒ Serial_ExecutePendingTransmits ⇒ HAL_UART_Transmit_DMA ⇒ HAL_DMA_Start_IT ⇒ DMA_SetConfig

[Calls]

- >> HAL_UART_TxCpltCallback

[Called By]

- >> HAL_UART_IRQHandler

UART_EndTxTransfer (Thumb, 18 bytes, Stack size 0 bytes, stm32f4xx_hal_uart.o(i.UART_EndTxTransfer))

[Called By]

- >> UART_DMAError

UART_Receive_IT (Thumb, 146 bytes, Stack size 8 bytes, stm32f4xx_hal_uart.o(i.UART_Receive_IT))

[Stack]

- Max Depth = 224
- Call Chain = UART_Receive_IT ⇒ HAL_UART_RxCpltCallback ⇒ Serial_RxCallback ⇒ Decode ⇒ DecodeParam ⇒ DecodeValue ⇒ ExecuteRequest ⇒ SetParamValue ⇒ Stepper_SetMinSPS ⇒ Stepper_SaveConfig ⇒ HAL_FLASH_Program ⇒ FLASH_WaitForLastOperation

[Calls]

- >> HAL_UART_RxCpltCallback

[Called By]

- >> HAL_UART_IRQHandler

UART_SetConfig (Thumb, 780 bytes, Stack size 24 bytes, stm32f4xx_hal_uart.o(i.UART_SetConfig))

[Stack]

- Max Depth = 28
- Call Chain = UART_SetConfig ⇒ HAL_RCC_GetPCLK2Freq

[Calls]

- >> HAL_RCC_GetPCLK2Freq
- >> HAL_RCC_GetPCLK1Freq

[Called By]

- >> HAL_UART_Init

UART_Transmit_IT (Thumb, 102 bytes, Stack size 0 bytes, stm32f4xx_hal_uart.o(i.UART_Transmit_IT))

[Called By]

- >> HAL_UART_IRQHandler

FLASH_Program_Byte (Thumb, 26 bytes, Stack size 0 bytes, stm32f4xx_hal_flash.o(i.FLASH_Program_Byte))

[Called By]

- >> HAL_FLASH_Program

FLASH_Program_DoubleWord (Thumb, 34 bytes, Stack size 8 bytes, stm32f4xx_hal_flash.o(i.FLASH_Program_DoubleWord))

[Stack]

- Max Depth = 8
- Call Chain = FLASH_Program_DoubleWord

[Called By]

- >> HAL_FLASH_Program

FLASH_Program_HalfWord (Thumb, 30 bytes, Stack size 0 bytes, stm32f4xx_hal_flash.o(i.FLASH_Program_HalfWord))

[Called By]

- >> HAL_FLASH_Program

FLASH_Program_Word (Thumb, 30 bytes, Stack size 0 bytes, stm32f4xx_hal_flash.o(i.FLASH_Program_Word))

[Called By]

- >> HAL_FLASH_Program

FLASH_SetErrorCode (Thumb, 96 bytes, Stack size 0 bytes, stm32f4xx_hal_flash.o(i.FLASH_SetErrorCode))

[Called By]

- >> FLASH_WaitForLastOperation

DMA_CalcBaseAndBitshift (Thumb, 38 bytes, Stack size 0 bytes, stm32f4xx_hal_dma.o(i.DMA_CalcBaseAndBitshift))

[Called By]

- >> HAL_DMA_Init

DMA_CheckFifoParam (Thumb, 120 bytes, Stack size 8 bytes, stm32f4xx_hal_dma.o(i.DMA_CheckFifoParam))

[Stack]

- Max Depth = 8
- Call Chain = DMA_CheckFifoParam

[Called By]

- >> HAL_DMA_Init

DMA_SetConfig (Thumb, 42 bytes, Stack size 12 bytes, stm32f4xx_hal_dma.o(i.DMA_SetConfig))

[Stack]

- Max Depth = 12
- Call Chain = DMA_SetConfig

[Called By]

- >> HAL_DMA_Start_IT

NVIC_SetPriority (Thumb, 32 bytes, Stack size 0 bytes, stm32f4xx_hal_cortex.o(i.NVIC_SetPriority))

[Called By]

- >> HAL_SYSTICK_Config
- >> HAL_NVIC_SetPriority

MX_DMA_Init (Thumb, 56 bytes, Stack size 8 bytes, main.o(i.MX_DMA_Init))

[Stack]

- Max Depth = 24
- Call Chain = MX_DMA_Init ⇒ HAL_NVIC_SetPriority

[Calls]

- >> HAL_NVIC_SetPriority
- >> HAL_NVIC_EnableIRQ

[Called By]

- >> main

MX_GPIO_Init (Thumb, 230 bytes, Stack size 56 bytes, main.o(i.MX_GPIO_Init))

[Stack]

- Max Depth = 96
- Call Chain = MX_GPIO_Init ⇒ HAL_GPIO_Init

[Calls]

- >> HAL_NVIC_SetPriority
- >> HAL_NVIC_EnableIRQ
- >> HAL_GPIO_WritePin
- >> HAL_GPIO_Init

[Called By]

- >> main

MX_TIM12_Init (Thumb, 150 bytes, Stack size 56 bytes, main.o(i.MX_TIM12_Init))

[Stack]

- Max Depth = 128
- Call Chain = MX_TIM12_Init ⇒ HAL_TIM_MspPostInit ⇒ HAL_GPIO_Init

[Calls]

- >> HAL_TIM_ConfigClockSource
- >> HAL_TIM_Base_Init
- >> HAL_TIM_PWM_Init
- >> HAL_TIM_PWM_ConfigChannel
- >> HAL_TIM_MspPostInit
- >> _Error_Handler

[Called By]

- >> main

MX_TIM14_Init (Thumb, 42 bytes, Stack size 8 bytes, main.o(i.MX_TIM14_Init))

[Stack]

- Max Depth = 40
- Call Chain = MX_TIM14_Init ⇒ HAL_TIM_Base_Init ⇒ TIM_Base_SetConfig

[Calls]

- >> HAL_TIM_Base_Init
- >> _Error_Handler

[Called By]

- >> main

MX_TIM3_Init (Thumb, 154 bytes, Stack size 64 bytes, main.o(i.MX_TIM3_Init))

[Stack]

- Max Depth = 136
- Call Chain = MX_TIM3_Init ⇒ HAL_TIM_MspPostInit ⇒ HAL_GPIO_Init

[Calls]

- >> HAL_TIM_ConfigClockSource
- >> HAL_TIM_Base_Init
- >> HAL_TIMEx_MasterConfigSynchronization
- >> HAL_TIM_PWM_Init
- >> HAL_TIM_PWM_ConfigChannel
- >> HAL_TIM_MspPostInit
- >> _Error_Handler

[Called By]

- >> main

MX_TIM4_Init (Thumb, 154 bytes, Stack size 64 bytes, main.o(i.MX_TIM4_Init))

[Stack]

- Max Depth = 136
- Call Chain = MX_TIM4_Init ⇒ HAL_TIM_MspPostInit ⇒ HAL_GPIO_Init

[Calls]

- >> HAL_TIM_ConfigClockSource
- >> HAL_TIM_Base_Init
- >> HAL_TIMEx_MasterConfigSynchronization
- >> HAL_TIM_PWM_Init
- >> HAL_TIM_PWM_ConfigChannel
- >> HAL_TIM_MspPostInit
- >> _Error_Handler

[Called By]

- >> main

MX_TIM5_Init (Thumb, 154 bytes, Stack size 64 bytes, main.o(i.MX_TIM5_Init))

[Stack]

- Max Depth = 136
- Call Chain = MX_TIM5_Init ⇒ HAL_TIM_MspPostInit ⇒ HAL_GPIO_Init

[Calls]

- >> HAL_TIM_ConfigClockSource
- >> HAL_TIM_Base_Init
- >> HAL_TIMEx_MasterConfigSynchronization
- >> HAL_TIM_PWM_Init
- >> HAL_TIM_PWM_ConfigChannel
- >> HAL_TIM_MspPostInit
- >> _Error_Handler

[Called By]

- >> main

MX_UART4_Init (Thumb, 50 bytes, Stack size 8 bytes, main.o(i.MX_UART4_Init))

[Stack]

- Max Depth = 112
- Call Chain = MX_UART4_Init ⇒ HAL_UART_Init ⇒ HAL_UART_MspInit ⇒ HAL_GPIO_Init

[Calls]

- >> HAL_UART_Init
- >> _Error_Handler

[Called By]

- >> main

_printf_core (Thumb, 658 bytes, Stack size 104 bytes, printf5.o(i._printf_core), UNUSED)

[Calls]

- >> __aeabi_uldivmod

[Called By]

- >> __0printf$5

### Undefined Global Symbols
