vuhuyhop197/SCARA/(list of files, drawings)

Other design files:
Hardware/LV_V1.PrjPcb
Hardware/PCB1.PcbDoc
Hardware/Sheet1.SchDoc
