vuhuyhop197/SCARA/Step_Control/Src/main.c

/**
  ******************************************************************************
  * @file           : main.c
  * @brief          : Main program body
  ******************************************************************************
  ** This notice applies to any and all portions of this file
  * that are not between comment pairs USER CODE BEGIN and
  * USER CODE END. Other portions of this file, whether 
  * inserted by the user or by software development tools
  * are owned by their respective copyright owners.
  *
  * COPYRIGHT(c) 2019 STMicroelectronics
  *
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
  ******************************************************************************
  */
/* Includes ------------------------------------------------------------------*/
#include "main.h"
#include "stm32f4xx_hal.h"
#include "math.h"
/* USER CODE BEGIN Includes */
#include "stepperController.h"
#include "stepperCommands.h"
#include "serial.h"
/* USER CODE END Includes */

TIM_HandleTypeDef htim3;
TIM_HandleTypeDef htim4;
TIM_HandleTypeDef htim5;
TIM_HandleTypeDef htim12;
TIM_HandleTypeDef htim14;

UART_HandleTypeDef huart4;
DMA_HandleTypeDef hdma_uart4_tx;
DMA_HandleTypeDef hdma_uart4_rx;

/* USER CODE BEGIN PV */
#define a1			10.0
#define a2			10.6
#define d4			11
/* USER CODE END PV */

void SystemClock_Config(void);
static void MX_GPIO_Init(void);
static void MX_DMA_Init(void);
static void MX_UART4_Init(void);
static void MX_TIM14_Init(void);
static void MX_TIM5_Init(void);
static void MX_TIM3_Init(void);
static void MX_TIM12_Init(void);
static void MX_TIM4_Init(void);                                    
void HAL_TIM_MspPostInit(TIM_HandleTypeDef *htim);
extern void Grap_object(int state);
extern void Set_Orient(float angle); 
extern void Set_Home();                  
void Calib_Home();
                                

/* USER CODE BEGIN PFP */

/* USER CODE END PFP */

/* USER CODE BEGIN 0 */
int32_t speed=0;
uint32_t STEP_TIMER_CLOCK;
uint32_t STEP_CONTROLLER_PERIOD_US;
double joint[4];
int count1,count2;
int CalibHome=0,Set_position=0;
stepper_error state;
/* USER CODE END 0 */

/**
  * @brief  The application entry point.
  *
  * @retval None
  */
int main(void)
{
  /* USER CODE BEGIN 1 */
  stepper_request stReq =  {'\0', CMD_GET, PARAM_ALL, 0, false};
  /* USER CODE END 1 */
	stepper_status Status;
  /* MCU Configuration----------------------------------------------------------*/

  /* Reset of all peripherals, Initializes the Flash interface and the Systick. */
  HAL_Init();

  /* Configure the system clock */
  SystemClock_Config();

  /* Initialize all configured peripherals */
  MX_GPIO_Init();
  MX_DMA_Init();
  MX_UART4_Init();
  MX_TIM14_Init();
  MX_TIM5_Init();
  MX_TIM3_Init();
  MX_TIM12_Init();
  MX_TIM4_Init();
  /* USER CODE BEGIN 2 */
	STEP_TIMER_CLOCK = HAL_RCC_GetHCLKFreq();
  STEP_CONTROLLER_PERIOD_US =  1000000U /(HAL_RCC_GetHCLKFreq() / htim14.Init.Period);
	Stepper_SetupPeripherals('X', &htim5, TIM_CHANNEL_3, GPIOE, GPIO_PIN_1);
  Stepper_SetupPeripherals('Y', &htim3, TIM_CHANNEL_1, GPIOD, GPIO_PIN_0);
	Stepper_SetupPeripherals('Z', &htim4, TIM_CHANNEL_1, GPIOD, GPIO_PIN_9);

	printf("\r\n");
  printf ("============== Stepper Hub ==============\r\n");
  printf ("  CPU Clock: %d MHz StepperCtrl: %d us\r\n", STEP_TIMER_CLOCK/1000000, STEP_CONTROLLER_PERIOD_US);
  printf ("=========================================\r\n\r\n");
	printf("Reading settings from internal storage...\r\n");
  Stepper_LoadConfig();
  
  //if (Stepper_GetAccPrescaler('Z') == 0xFFFFFFFF) {
    printf("Storage is clean, initializing defaults ...\r\n");
    Stepper_InitDefaultState('X');
		Stepper_InitDefaultState('Y');
		Stepper_InitDefaultState('Z');
    Stepper_SaveConfig();
  //}

  printf("DONE!\r\n\r\n");
	 
	HAL_GPIO_WritePin(En_X_Port,En_X_Pin,Stop);
	HAL_GPIO_WritePin(En_Y_Port,En_Y_Pin,Stop);
	HAL_GPIO_WritePin(En_Z_Port,En_Z_Pin,Stop);
	__HAL_TIM_ENABLE_IT(&htim5, TIM_IT_UPDATE);
  __HAL_TIM_ENABLE_IT(&htim3, TIM_IT_UPDATE);
	__HAL_TIM_ENABLE_IT(&htim4, TIM_IT_UPDATE);
//	Stepper_SetAccPrescaler('X',113);
//	Stepper_SetAccPrescaler('Y',113);

	Serial_InitRxSequence();
	HAL_Delay(1);
	HAL_TIM_Base_Start_IT(&htim14);
	stReq.stepper = 'X';
  ExecuteRequest(&stReq);
	stReq.stepper = 'Y';
  ExecuteRequest(&stReq);
	stReq.stepper = 'Z';
	ExecuteRequest(&stReq);

//	Stepper_SetAccPrescaler('Z',113);

//	Stepper_SetMinSPS('X',100);
//	Stepper_SetMinSPS('Y',100);
	//Stepper_SetMinSPS('Z',1000);

//	Stepper_SetMaxSPS('X',100000);
//	Stepper_SetMaxSPS('Y',100000);
//	Stepper_SetMaxSPS('Z',10000);


	
	Stepper_InitDefaultState('X');
	Stepper_InitDefaultState('Y');
	Stepper_InitDefaultState('Z');
	Stepper_SetAccSPS('X',2);
	Stepper_SetAccSPS('Y',2);
	Stepper_SetAccSPS('Z',5);
	Stepper_SetCurrentPosition('Z',22000);
	state =Stepper_SetAccPrescaler('X',5000);
	state=Stepper_SetAccPrescaler('Y',5000);
	state=Stepper_SetAccPrescaler('Z',500);
//	inverse_kinetic(20.6,0,0,0,&joint[0]);
	HAL_TIM_PWM_Start(&htim12,TIM_CHANNEL_2);
	
	
	Set_Home();
	

  /* USER CODE END 2 */

  /* Infinite loop */
  /* USER CODE BEGIN WHILE */
  while (1)
  {
  /* USER CODE END WHILE */
		Calib_Home();
		//speed = Stepper_GetCurrentSPS('Y');
	}
	
}
void Calib_Home(){
	if(!CalibHome){
			if(count1 ==0)
			{
				HAL_GPIO_WritePin(En_X_Port,En_X_Pin,Start);
				Stepper_SetTargetPosition('X',Stepper_GetCurrentPosition('X')+2);
			}
			else{
				if(count2 ==0)
				{
					HAL_GPIO_WritePin(En_Y_Port,En_Y_Pin,Start);
					
					Stepper_SetTargetPosition('Y',Stepper_GetCurrentPosition('Y')-2);
					speed=Stepper_GetCurrentPosition('Y')-2;
				}
			}
		}
	if(Set_position){
			if(Stepper_GetStatus('X')==SS_STOPPED){
				if(Stepper_GetStatus('Y')==SS_STOPPED){
						Stepper_SetCurrentPosition('X',Max_X_Pos);
						Stepper_SetCurrentPosition('Y',-(Max_Y_Pos));
							Stepper_SetCurrentPosition('Z',22000);
						Set_position=0;
				}
		}
	}
}
void HAL_GPIO_EXTI_Callback(uint16_t GPIO_Pin){
	if(GPIO_Pin==GPIO_PIN_10){
		count1++;
	}
		if(GPIO_Pin==GPIO_PIN_11){
		count2++;
		HAL_GPIO_WritePin(En_X_Port,En_X_Pin,Stop);
		HAL_GPIO_WritePin(En_Y_Port,En_Y_Pin,Stop);
		HAL_GPIO_WritePin(En_Z_Port,En_Z_Pin,Stop);
		Set_position =1;
	}
}
void Set_Home(){
	count1 =0;
	count2 =0;
	CalibHome =0;
	if(HAL_GPIO_ReadPin(GPIOB,GPIO_PIN_11)==0||HAL_GPIO_ReadPin(GPIOB,GPIO_PIN_10)==0)
	{
		if(HAL_GPIO_ReadPin(GPIOB,GPIO_PIN_11)==0&&HAL_GPIO_ReadPin(GPIOB,GPIO_PIN_10)==0)
			{
				Set_position =1;
			}
		HAL_GPIO_WritePin(En_X_Port,En_X_Pin,Stop);
		HAL_GPIO_WritePin(En_Y_Port,En_Y_Pin,Stop);
		HAL_GPIO_WritePin(En_Z_Port,En_Z_Pin,Stop);
		HAL_TIM_PWM_Stop(&htim12,TIM_CHANNEL_1);
		CalibHome =1;
	}
}
void inverse_kinetic(double x,double y, double z,double anpha,double* joints){
	//calculate d1 theta1 theta2 theta4
	double c2,s2_1,s2_2,temp[2];
	c2 = (pow(x,2)+pow(y,2)-pow(a1,2)-pow(a2,2))/(2*a1*a2);
	s2_1 = sqrt(1-pow(c2,2));
	s2_2 = -sqrt(1-pow(c2,2));
	joints[0] = z + d4;
	joints[2] = atan2(s2_1,c2);
	joints[1] = atan2(y,x) - atan2(a2*sin(joints[2]),a1+a2*cos(joints[2]));
	joints[3] = joints[1] + joints[2] - anpha;
	temp[0]= atan2(s2_2,c2);
	temp[1]= atan2(y,x) - atan2(a2*sin(temp[0]),a1+a2*cos(temp[0]));
	if((fabs(temp[0])+fabs(temp[1]))<(fabs(joints[1])+fabs(joints[2]))){
		joints[2]=temp[0];
		joints[1]=temp[1];				//get the minimum value of theta
	}
}
void Grap_object(int state)
{
	if(state == 1){
	HAL_TIM_PWM_Start(&htim12,TIM_CHANNEL_1);
	__HAL_TIM_SetCompare(&htim12,TIM_CHANNEL_1,2100);
	}
	else{
	HAL_TIM_PWM_Start(&htim12,TIM_CHANNEL_1);
	__HAL_TIM_SetCompare(&htim12,TIM_CHANNEL_1,1600);
	}
//		HAL_Delay(60);
//		HAL_TIM_PWM_Stop(&htim12,TIM_CHANNEL_1);
}
void Set_Orient(float angle)
{
	__HAL_TIM_SetCompare(&htim12,TIM_CHANNEL_2,angle*2100/180+500);
}			
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
