vuhuyhop197/SCARA/Step_Control/LV_code_v2.ioc

Mcu.UserName=STM32F407VGTx
PA0-WKUP.Signal=UART4_TX
PA1.Signal=UART4_RX
PA2.Signal=S_TIM5_CH3
PA3.Signal=GPIO_Output
PA6.Signal=S_TIM3_CH1
PA7.Signal=GPIO_Output
PB10.Signal=GPXTI10
PB11.Signal=GPXTI11
PB14.Signal=S_TIM12_CH1
PB15.Signal=S_TIM12_CH2
PD0.Signal=GPIO_Output
PD12.Signal=S_TIM4_CH1
PD13.Signal=GPIO_Output
PD4.Signal=GPIO_Output
PD9.Signal=GPIO_Output
PE1.Signal=GPIO_Output
PE3.Signal=GPIO_Output
PH0-OSC_IN.Signal=RCC_OSC_IN
PH1-OSC_OUT.Signal=RCC_OSC_OUT
