vuhuyhop197/SCARA/Step_Control/Src/stepperCommands.c

#include <string.h>
#include "stepperCommands.h"
#include "stepperController.h"
#include "serial.h"
#include "stm32f4xx_hal.h"

/*
REQUEST STRUCTURE
  
    <command><stepper>[.parameter][:value]
    
  where

    <command>     : add | set | reset | get
    
    <stepper>     : X | Y | Z (or whatever single-letter names will be added in the future)
    
    [.parameter]  : parameter name (the field of the stepper_state structure)
    
                        read/write params (supported by all commands):
                        
                                .targetPostion
                                .currentPostion 
                                .minSPS 
                                .maxSPS

                        read-only params ("get" command only)
                                .accSPS
                                .accPrescaller                        
                                .currentSPS
                                .status
                                .all
                            
    [:value]      : any int32_t value (-2147483648 .. 2147483647) prefixed with colon, used with "add" or "set" request.

  [.parameter] and/or [:value] might be omitted, so defaults will be used instead:

    - when the [.parameter] is omitted:
        "targetPosition" assumed by default for "add" and "set" commands
        "currentPosition" for "get" command
        
    - when the [:value] is omitted: 
        0 assumed by default (for all commands)
        
  [:value] makes no sense for "get" and "reset" command, so will be ignored in this case.

RESPONSE STRUCTURE

    <status> - <code|stepper><info>
  
  where
    
    <status>  : OK | LIMIT | ERROR
    <info>    : command confirmation info (in case of successful "OK", or error code and description in case of error)
  
EXAMPLES

  -------------------------------------------
    REQUEST
              setX.maxSPS:2000
                - command    = set
                - stepper    = X
                - parameter  = maxSPS
                - value      = 2000
    RESPONSE
              OK - X.maxSPS:2000
  -------------------------------------------
    REQUEST  
              setY:325
                - command    = set
                - stepper    = Y
                - parameter  = targetPostion
                - value      = 325
    RESPONSE
              OK - Y.targetPosition:325
  -------------------------------------------
    REQUEST  
              addX:-400
                - command    = add
                - stepper    = X
                - parameter  = targetPosition
                - value      = -200
                RESPONSE (assuming that old targetPosition:325)
              OK - X.targetPosition:-75
  -------------------------------------------
    REQUEST  
              getZ
                - command    = get
                - stepper    = Z
                - parameter  = currentPostion
                - value      = N/A
    RESPONSE
              OK - Z.currentPostion:-198496
  -------------------------------------------
    REQUEST  
              getZ.minSPS:4894
                - command    = get
                - stepper    = Z
                - parameter  = minSPS
                - value      = 4894 - ignored, N/A for "get" command
    RESPONSE
              OK - Z.minSPS:25
  -------------------------------------------
    REQUEST  
              getX.all
                - command    = get
                - stepper    = X
                - parameter  = all
                - value      = N/A
    RESPONSE
              OK - X
              .accPrescaler:10
              .accSPS:5
              .minSPS:10
              .maxSPS:4000
              .currentSPS:525
              .currentPostion:2000
              .targetPosition:-150
              .status:1(RUNNING_BACKWARD)
              

============================================
!!!!!!!!! -------  WARNING ------- !!!!!!!!!
============================================

Request decoding happens on the fly, with every new received byte (we are not wating for request termination char(s), like '\r', '\n' or '\r\n')
This is preferable way. Since it distributes computation which required for the whole request decoding over the time (we don't do everyting in a single interrupt handler).
While the decoding alghoritm itself is a little more complex - less CPU time required when the last request symbol arrives, 
the beginning of request, all the previous content, has been already decoded by this moment.
Since no requst termination chars required - you may write a set of commands in one line, without spaces or anything (data bandwidth utilized more efficiently).
But the only disadvantage is that there are ceratin limitations to the request fileds content:

  1. Neither of <command>   is allowed to be a substring of any another <command>.
  2. Neither of <parameter> is allowed to be a substring of any another <parameter>.
  
*/

#define En_X_Pin	GPIO_PIN_3
#define	En_X_Port	GPIOE
#define En_Y_Pin 	GPIO_PIN_4
#define En_Y_Port GPIOD
#define	Start 	1
#define Stop 		0
static char * request_commands_arry[__CMD_COUNT] = {"UNKNOWN", "ADD", "GET", "SET", "RESET","GRAP","ORT","HOME"};
static char * request_params_arry[__PARAM_COUNT] = {"UNDEFINED", "ALL", "TARGETPOSITION", "CURRENTPOSITION", "MINSPS", "MAXSPS", "CURRENTSPS", "ACCSPS", "ACCPRESCALER", "STATUS","TAKE","DROP"};


typedef enum {
  REQ_FIELD_CMD       = 0,
  REQ_FIELD_STEPPER   = 1,
  REQ_FIELD_PARAM     = 2,
  REQ_FIELD_VALUE     = 3
} request_fields;

typedef enum {
 SCERR_OK               = 0,
 SCERR_VALUELIMIT       = 1,
 SCERR_MUSTBESTOPPED    = 2,
 SCERR_STEPPERNOTFOUND  = 3,
 SCERR_INVALIDCMDPARAM  = 4,
 SCERR_UNKNONWERROR     = 5
}  stepper_command_error;


static volatile request_fields currentReqField = REQ_FIELD_CMD;
static volatile int32_t currentReqFieldIndex = 0;
// this holds the list of options left to decode filtered by icomming data
// every new byte which doesn't fit the possible decoded option will reset corresponding bit-flag
static uint32_t filteredItems = UINT32_MAX;
// Global decoded request from UART stream
static stepper_request req = {'\0', CMD_UNKNOWN, PARAM_UNDEFINED, 0, false};

void DecodeCmd(uint8_t data);
void DecodeStepper(uint8_t data);
void DecodeParam(uint8_t data);
void DecodeValue(uint8_t data);
int32_t target_pos,current_pos;
int32_t GetParamValue(char stepper, request_params param) {
    switch (param) {
        case PARAM_TARGETPOSITION:  return Stepper_GetTargetPosition(stepper);
        case PARAM_CURRENTPOSITION: return Stepper_GetCurrentPosition(stepper);
        case PARAM_MINSPS:          return Stepper_GetMinSPS(stepper);
        case PARAM_MAXSPS:          return Stepper_GetMaxSPS(stepper);
        case PARAM_CURRENTSPS:      return Stepper_GetCurrentSPS(stepper);
        case PARAM_ACCSPS:          return Stepper_GetAccSPS(stepper);
        case PARAM_ACCPRESCALER:    return Stepper_GetAccPrescaler(stepper);
        case PARAM_STATUS:          return Stepper_GetStatus(stepper);
        default:  return 0;
    }
}

stepper_error SetParamValue(char stepper, request_params param, int32_t value) {
      switch (param) {
        case PARAM_TARGETPOSITION:
					
				target_pos= value;
					if (stepper=='X'){
						HAL_GPIO_WritePin(En_X_Port,En_X_Pin,Start);
						HAL_GPIO_WritePin(En_Y_Port,En_Y_Pin,Start);
					}
					else if(stepper=='Y'){
						HAL_GPIO_WritePin(En_X_Port,En_X_Pin,Start);
						HAL_GPIO_WritePin(En_Y_Port,En_Y_Pin,Start);
					}
					else if(stepper=='Z'){
						HAL_GPIO_WritePin(En_Z_Port,En_Z_Pin,Start);
					}
					return Stepper_SetTargetPosition(stepper, value);
        case PARAM_CURRENTPOSITION:
					return Stepper_SetCurrentPosition(stepper, value);
        case PARAM_MINSPS:         
					return Stepper_SetMinSPS(stepper, value);
        case PARAM_MAXSPS:         
					return Stepper_SetMaxSPS(stepper, value);
        default:  return (stepper_error)0xFF; // codding error, will give "Unknown error" output
    }
}

void PrintStepperStatusStr(stepper_status status) {
  char * separator = "";
  if (status & SS_STOPPED) {
    printf("STOPPED");
    separator = " | ";
  }
  if (status & SS_BREAKING) {
    printf("%sBREAKING", separator);
    separator = " | ";
  }
  if (status & SS_BREAKCORRECTION) {
    printf("%sBREAKCORRECTION", separator);
    separator = " | ";
  }
  if (status & SS_STARTING) {
    printf("%sSTARTING", separator);
    separator = " | ";
  }
  if (status & SS_RUNNING_BACKWARD) {
    printf("%sRUNNING_BACKWARD", separator);
    separator = " | ";
  }
  if (status & SS_RUNNING_FORWARD) {
    printf("%sRUNNING_FORWARD", separator);
  }
  if (status == 0x00) {
    printf("UNDEFINED");
  }
}

void ExecuteRequest(stepper_request * r) {
  stepper_error setResult = SERR_OK;
  stepper_command_error error = SCERR_OK;
  
  char stepper = r->stepper;
  request_commands command = r->command;    
  request_params parameter = r->parameter;
  int64_t value = (r->isNegativeValue) ? -r->value : r->value;
 
  // TRY EXECUTE COMMAND
    
  if (stepper == '\0') {
    error = SCERR_STEPPERNOTFOUND;
  } else {
    switch (command) {
      case CMD_ADD:
      case CMD_SET:
        // VALIDATION
        if (parameter == PARAM_ACCSPS ||
            parameter == PARAM_ACCPRESCALER ||
            parameter == PARAM_CURRENTSPS ||
            parameter == PARAM_STATUS || 
            parameter == PARAM_ALL) {
            error = SCERR_INVALIDCMDPARAM;
            break;
        }
        // DEFAULTING
        if (parameter == PARAM_UNDEFINED)
            parameter = PARAM_TARGETPOSITION;
        // EXECUTION
        if (command == CMD_ADD) {
            value += GetParamValue(stepper, parameter);
        }
        if (value < INT32_MIN) {
            value = INT32_MIN;
            error = SCERR_VALUELIMIT;
        }
        if (value > INT32_MAX) {
            value = INT32_MAX;
            error = SCERR_VALUELIMIT;
        }        
        setResult = SetParamValue(stepper, parameter, value);
        break;
      case CMD_RESET:
        // VALIDATION
        if (!(Stepper_GetStatus(stepper) & SS_STOPPED)){
            error = SCERR_MUSTBESTOPPED;
            break;
        }
        // DEFAULTING
        // Undefined parameter in RESET command means - reset everything!
        if (parameter == PARAM_UNDEFINED)
            parameter = PARAM_ALL;
        // current position and target position must be reset at the same time
        // writing to current position - rewrites target position with the same value
        if (parameter == PARAM_TARGETPOSITION)
            parameter = PARAM_CURRENTPOSITION;
        // EXECUTIONG
        switch (parameter) {
            case PARAM_ALL:
                setResult = Stepper_InitDefaultState(stepper);
                Stepper_SaveConfig();
                break;
            case PARAM_MINSPS:
                setResult = Stepper_SetMinSPS(stepper, DEFAULT_MIN_SPS);
                break;
            case PARAM_MAXSPS:
                setResult = Stepper_SetMaxSPS(stepper, DEFAULT_MAX_SPS);
                break;
            case PARAM_CURRENTPOSITION:
                setResult = Stepper_SetCurrentPosition(stepper, 0);
                break;
            case PARAM_ACCSPS:
            case PARAM_ACCPRESCALER:
            case PARAM_CURRENTSPS:
            case PARAM_STATUS:
                error = SCERR_INVALIDCMDPARAM;
                break;
            default:
                error = SCERR_UNKNONWERROR;
                break;
        }
        break;
      case CMD_GET:
        if (parameter == PARAM_UNDEFINED)
            parameter = PARAM_CURRENTPOSITION;
        if (parameter != PARAM_ALL)
            value = GetParamValue(stepper, parameter);
        break;
			case CMD_Grap:
				if(parameter == PARAM_TAKE)
				Grap_object(1);
				if(parameter == PARAM_DROP)
				Grap_object(0);
				break;
			case CMD_Orient:
				Set_Orient(value);
			break;
			case CMD_Home:
				Set_Home();
			break;
      default:
        // This case should not ever happen.
        printf("ERROR -  Program error in commands decoder.");
        break;
    }
  }
  
  // PRINT RESPONSE
  
  switch (setResult) {
    case SERR_OK: break;
    case SERR_LIMIT: 
        // read the value limit being set
        value = GetParamValue(stepper, parameter);
        error = SCERR_VALUELIMIT;
        break;
    case SERR_STATENOTFOUND:    error = SCERR_STEPPERNOTFOUND; break; // this is unlikely to happen, since we check while decoding
    case SERR_MUSTBESTOPPED:    error = SCERR_MUSTBESTOPPED; break;
    default:                    error = SCERR_UNKNONWERROR; break;
  }
  
  if (error == SCERR_VALUELIMIT) {
      printf("LIMIT - %c.%s = %d\r\n", stepper, request_params_arry[parameter], (int32_t)value);
  } else if (error) {
    char * errorStr;
    switch(error) {
        case SCERR_MUSTBESTOPPED    : errorStr = "Stepper must be STOPPED to execute this command."; break;
        case SCERR_STEPPERNOTFOUND  : errorStr = "No stepper with specified label."; break;
        case SCERR_INVALIDCMDPARAM  : errorStr = "Invalid command parameter."; break; 
        default                     : errorStr = "Unknown error."; break;
    }
    printf("ERROR - %d %s\r\n", error, errorStr);
  } else {
    printf("OK - %c", stepper);
    if (parameter == PARAM_ALL) {
        printf("\r\n");
        // start with whatever goes after PARAM_ALL
        request_params param = (request_params)(PARAM_ALL + 1);
        do {
            value = GetParamValue(stepper, param);
            if (param == PARAM_STATUS) {
                printf("\t.%s = 0x%.2X ", request_params_arry[param], (int32_t)value);
                PrintStepperStatusStr((stepper_status)value);
                printf("\r\n");
            } else {
                printf("\t.%s = %d\r\n", request_params_arry[param], (int32_t)value);
            }
            param++;
        } while (param < __PARAM_COUNT);
    } else {
        if (parameter == PARAM_STATUS) {
            printf(".%s = 0x%X2 ", request_params_arry[parameter], (int32_t)value);
            PrintStepperStatusStr((stepper_status)value);
            printf("\r\n");
        } else {
							printf(".%s = %d\r\n", request_params_arry[parameter], (int32_t)value);
        }
    }
  }
}

void CleanupDecoder(void) {
      // Prepare to decode next command
  req.command         = CMD_UNKNOWN;
  req.stepper         = '\0';
  req.parameter       = PARAM_UNDEFINED;
  req.value           = 0;
  req.isNegativeValue = false;
  
  currentReqField = REQ_FIELD_CMD;
  currentReqFieldIndex = 0;
}

void DecodeCmd(uint8_t data) {
  int filteredItemsCount = __CMD_COUNT - 1;       // exclude CMD_UNKNOWN from filter
  request_commands cmd = (request_commands) 1;  // start with whatever CMD goes first (but not CMD_UNKNOWN = 0) 
  
  int validCmdLength;
  request_commands validCmd = CMD_UNKNOWN;
  
  if (currentReqFieldIndex == 0) {   
    filteredItems = UINT32_MAX;
  }
  
  do {
    if (filteredItems & (1u << cmd)) {
      char * cmdStr = request_commands_arry[cmd];
      int cmdLength = strlen(cmdStr);  
      if (cmdLength > currentReqFieldIndex && cmdStr[currentReqFieldIndex] == data) {
        validCmd = cmd;
        validCmdLength = cmdLength;
      } else {
        filteredItems &= ~(1 << cmd);
        filteredItemsCount --;
      }
    } else {
      // CMD has been filtered earlier
      filteredItemsCount --;
    }
    cmd++;
  } while (cmd < __CMD_COUNT);
  
  // nothing found, everything has been filtered out
  if (filteredItemsCount == 0) {
    
    // we were at the begining of CMD decoding,
    // but data character doesn't go as first symbol of any known command
    // so we just keep looking for the one which fits.
    
    if (currentReqFieldIndex > 0) {
      // if we passed thorugh a symbol or two - it could be some data loss
      // the current symbol might be the begining of new command
      // try recursively recognize it
      currentReqFieldIndex = 0;
      DecodeCmd(data);
    }
    
    return;
  } else if (filteredItemsCount == 1 && validCmdLength - 1 == currentReqFieldIndex) {
    // remember decoded CMD
    req.command = validCmd;
    // goto STEPPER decoding
    currentReqField = REQ_FIELD_STEPPER;
    currentReqFieldIndex = 0;
  } else {
    // Prepare to validate next char of the parameter name
    currentReqFieldIndex++;
  }
}

void DecodeStepper(uint8_t data) {
  if (Stepper_GetStatus(data) == SS_UNDEFINED) {
    // There is no such stepper found
    // So return error immediately
    ExecuteRequest(&req);
    CleanupDecoder();
    // So, now we might be looking also on the very forst char of the next command
    DecodeCmd(data); 
    return;
  }
  // remember it and continue if everything is good 
  req.stepper = data;
//	if(req.command == 2){
//		ExecuteRequest(&req);
//		currentReqField = REQ_FIELD_CMD;
//	}
//	else{
//		// Goto PARAM decoding
//		currentReqField = REQ_FIELD_PARAM;
//		currentReqFieldIndex = 0;
//	}
	currentReqField = REQ_FIELD_PARAM;
	currentReqFieldIndex = 0;
}

void DecodeParam(uint8_t data) {
  int filteredItemsCount = __PARAM_COUNT - 1;   // exclude PARAM_UNDEFINED from filter
  request_params param = (request_params) 1;  // start with whatever PARAM goes first (but not PARAM_UNDEFINED = 0) 
  
  int validParamLength;
  request_params validParam = PARAM_UNDEFINED;
  
  int charIndex = currentReqFieldIndex - 1;
  
  if (currentReqFieldIndex == 0) {   
    // the first symbol should go "." separator
    if (data == '.') {
      filteredItems = UINT32_MAX;
      currentReqFieldIndex++;
      return;
    } 
    
    // Missing expected parameter separator
    // goto VALUE decoding, which might go next
    currentReqField = REQ_FIELD_VALUE;
    // and we might look at the first value char at the moment - so go for it
    DecodeValue(data);
    return;
  }
  
  do {
    // filter check to avoid excessive calculations
    if (filteredItems & (1 << param)) {
      char * paramStr = request_params_arry[param];
      int paramLength = strlen(paramStr); 
      if (paramLength > charIndex && paramStr[charIndex] == data) {
        validParam = param;
        validParamLength = paramLength;
      } else {
        filteredItems &= ~(1 << param);
        filteredItemsCount --;
      }
    } else {
      // PARAM has been filtered earlier
      filteredItemsCount --;
    }
    param++;
  } while (param < __PARAM_COUNT);
  
  // if we have only one item in the filtered list and we reached its end - we are done with PARAM decoding
  if (filteredItemsCount == 1 && validParamLength == charIndex+1) {
    // remember decoded PARAM
    req.parameter = validParam;
    // goto value decoding
    currentReqField = REQ_FIELD_VALUE;
    currentReqFieldIndex = 0;
    return;
  }

  // if all params have been filtered out - the data character might belong to, 
  // the REQ_FIELD_VALUE or the begining of next command (REQ_FIELD_CMD).
  if (filteredItemsCount == 0) {
    // goto value decoding
    currentReqField = REQ_FIELD_VALUE;
    currentReqFieldIndex = 0;
    // and we might look at the first value char at the moment - so go for it
    DecodeValue(data);
    return;
  }
  
  // Prepare to validate next char of the parameter name
  currentReqFieldIndex++;
}

void DecodeValue(uint8_t data) {
  if (currentReqFieldIndex == 0) {
    // the first symbol should go ":" separator
    if (data == ':') {
      currentReqFieldIndex++;
      return;
    } 
    
    // Missing expected parameter separator
    // maybe there are no optional value provided
    // so execute whatever we got
    ExecuteRequest(&req);
    CleanupDecoder();
    // and we might be looking at the first char of the next command
    // so - go for it!
    DecodeCmd(data);
    return;
  }
  
  if (currentReqFieldIndex == 1) {
    // Remember that we are decoding negative value, e.g. "setX:-2131"
    if (data == '-') {
      req.isNegativeValue = true;
      currentReqFieldIndex++;
      return;
    }
    
    // Just skip in case of there is a positive sign, e.g. "setX:+2131"
    if (data == '+') {
      currentReqFieldIndex++;
      return;
    }
  }
  
  // This is the number of chars we have with ":", sign specifier "+/-" and the actual 10 digits for int32
  // ":-2147483648" to ":+2147483647"
  // so, maximum currentReqFieldIndex value is 11
  // to detect the OVERFLOW error we should catch at least 12 chars (if there are more than 11). 

  static const int INT32_OVERFLOW = 12;
    
  if (data>='0' && data<='9' && currentReqFieldIndex <= INT32_OVERFLOW) {
    req.value *= 10;
    req.value += data - '0'; 
    currentReqFieldIndex++;
  }
  else {
    ExecuteRequest(&req);
    CleanupDecoder();
    // and we might be looking at the first char of the next command
    // so - go for it!
    DecodeCmd(data);
		currentReqField = REQ_FIELD_CMD;
  }
}

void Decode(uint8_t data) {
  // to upper
  if (data >= 'a' && data <= 'z') {
    data -= ('a' - 'A');
  }

  switch (currentReqField){
    case REQ_FIELD_CMD:
      DecodeCmd(data);
      break;
    case REQ_FIELD_STEPPER:
      DecodeStepper(data);
      break;
    case REQ_FIELD_PARAM:
      DecodeParam(data);
      break;
    case REQ_FIELD_VALUE:
      DecodeValue(data);
      break;
  }
}

// Override serial interface callback
// TODO: Implement other interfaces in future if needed (I2C, CAN, etc) 
void Serial_RxCallback(uint8_t data) {
   Decode(data);
}
