vuhuyhop197/SCARA/(commit log)

2019-06-02 Stm32F4 stepper controll
    [LV_V1.PrjPcb, PCB1.PcbDoc, Sheet1.SchDoc]
2019-06-02 Stm32F4 board
    [LV_V1.PrjPcb, PCB1.PcbDoc, Sheet1.SchDoc]
2019-06-02 increase x,y veloc
