vuhuyhop197/SCARA/(notices)

Notices in the files:
Step_Control/Src/main.c:
(C) COPYRIGHT STMicroelectronics *****END OF FILE
